kounst/daGloane/README.md

daGloane
========

daGloane is a quadcopter with a takeoff mass of less than 30grams
