kounst/daGloane/HW/eagle/Bluetooth_interface/BT_interface_layout.png

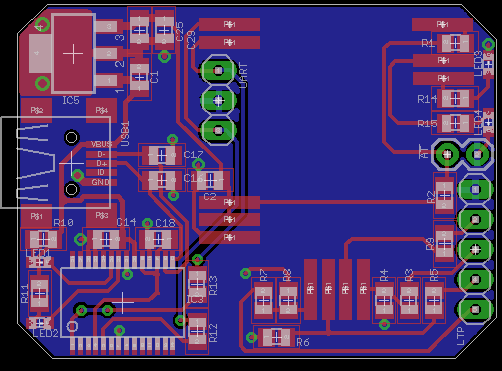
HW/eagle/Bluetooth_interface/BT_interface_layout.png
