kounst/daGloane/HW/eagle/Bluetooth_interface/BT_interface_schematic.png

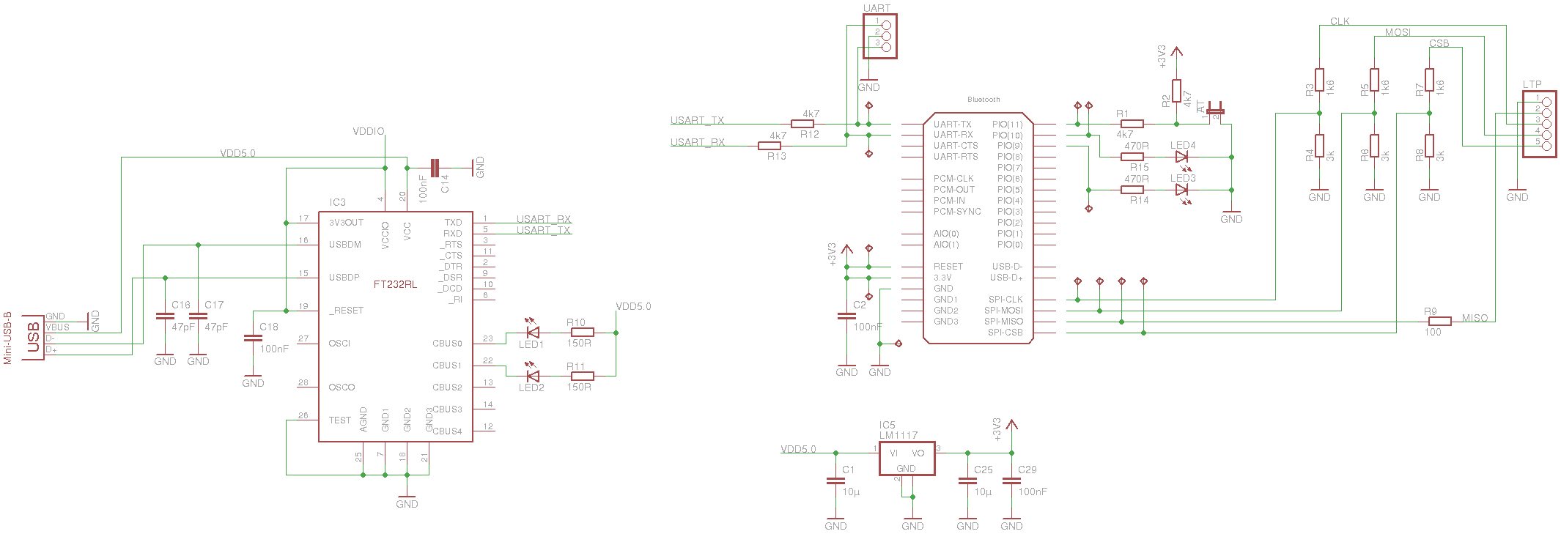
HW/eagle/Bluetooth_interface/BT_interface_schematic.png
