kounst/daGloane/HW/eagle/daGloane_schematic.png

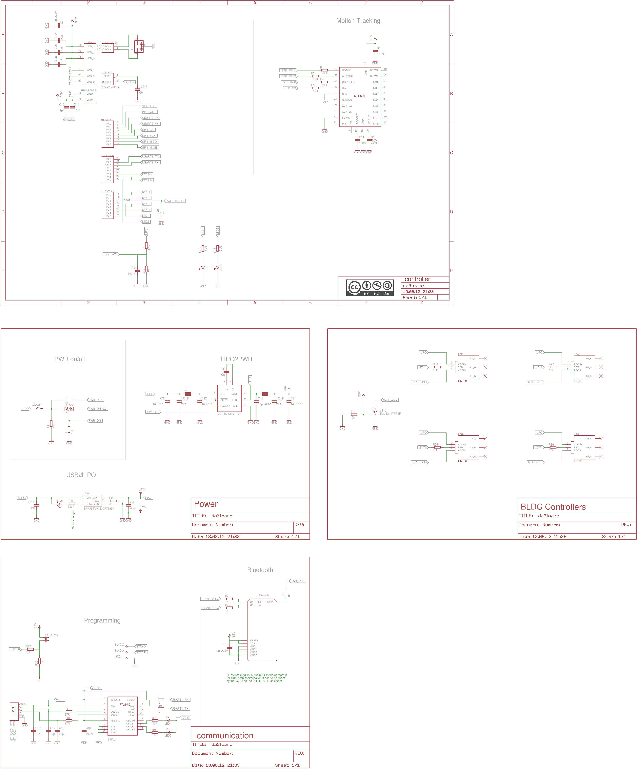
HW/eagle/daGloane_schematic.png
