kounst/daGloane/SW/src/simulink_control/daGloane_orientation.png

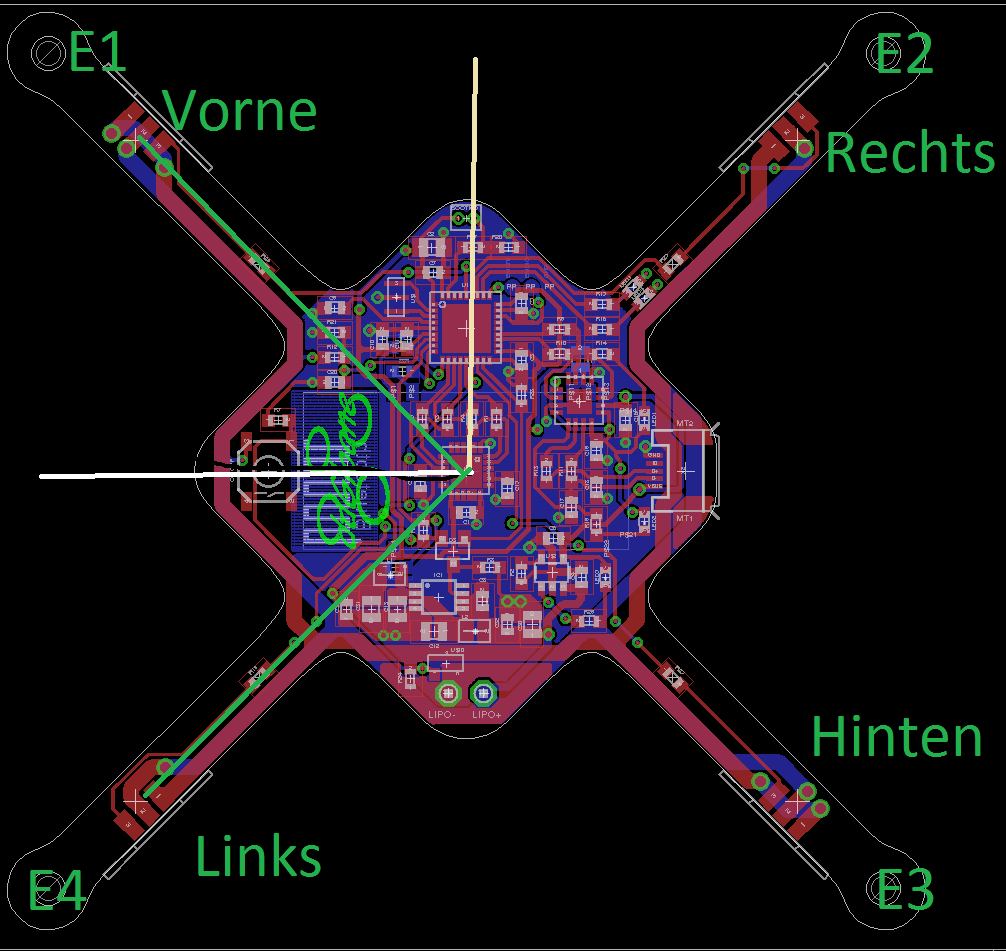
SW/src/simulink_control/daGloane_orientation.png
