kounst/daGloane/HW/Gewicht_abschätzung.ods

Abschätzung Gewicht daGloane
Bauteil | Anzahl | Stückgewicht/g | Gewicht/g | Kommentar
PCB mit 1929mm², 75%Kupferauslastung, 1.5mm Dicke | 1 | 7,57 | 7,57 | http://www.leiton.de/leiton-tools-gewichtsberechnung.html
Propeller | 4 | 0,6 | 2,4
Motor | 4 | 2 | 8
BLDC Regler | 4 | 0,4 | 1,6
Akku mit Kabel | 1 | 3,2 | 3,2
Bluetooth Modul | 1 | 2 | 2 | Schätzung
R 0603 | 30 | 0,002 | 0,06
C 0603 | 20 | 0,002 | 0,04
C 0805 | 3 | 0,008 | 0,024 | Schätzung: aus 0603 hochgerechnet
STM32 QFN32 | 1 | 0,13 | 0,13
FT230X QFN16 | 1 | 0,036 | 0,036
SOT23-3 Diode; Mosfet | 2 | 0,008 | 0,016
SOT23-5 LiPo lade IC | 1 | 0,012 | 0,012
MSOP-8 DC/DC | 1 | 0,025 | 0,025
MPU6000: QFN24 4x4 | 1 | 0,042 | 0,042 | Schätzung: wie R0603
LED | 5 | 0,002 | 0,01
Ceramic Resonator | 1 | 0,012 | 0,012
Lötzinn | 1 | 0,279 | 0,279 | Schätung: Lötzinn wiegt so viel wie Bauelemente
Micro USB B connector | 1 | 0,4 | 0,4 | Schätzung
Tactile Switch | 1 | 0,1 | 0,1
Jumper | 1 | 0,03 | 0,03 | Schätzung
Summe |  |  | 25,986
