kounst/daGloane/HW/CAD/PCB_serialWire.FCStd

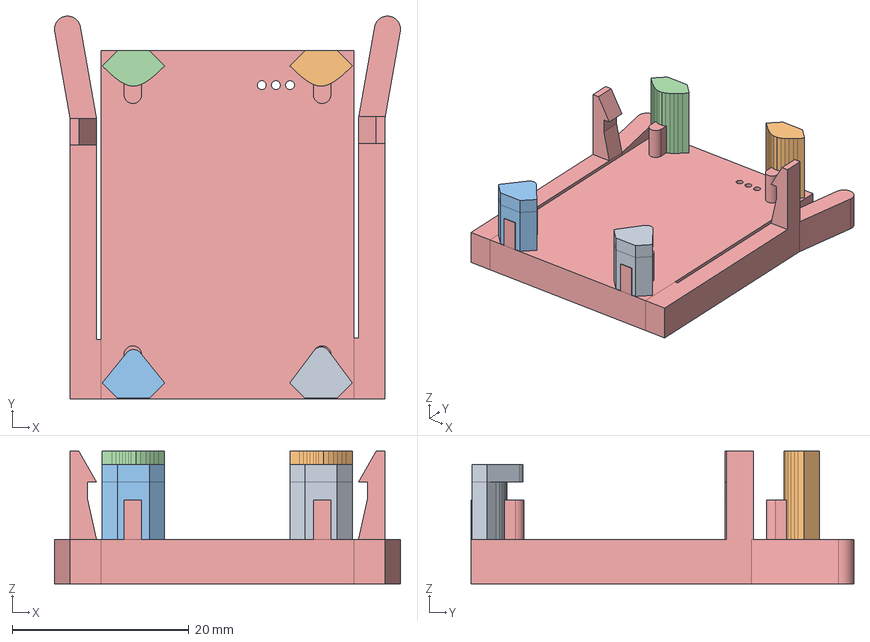
[picture p6: CAD file, 2021-02-18]
HW/CAD/PCB_serialWire.FCStd
39.1 x 43.3 x 15.0 mm
pillar_LR
pillar_UR
pillar_LL
pillar_UL
base
