kounst/daGloane/HW/CAD/SerialWire Fixture.stl

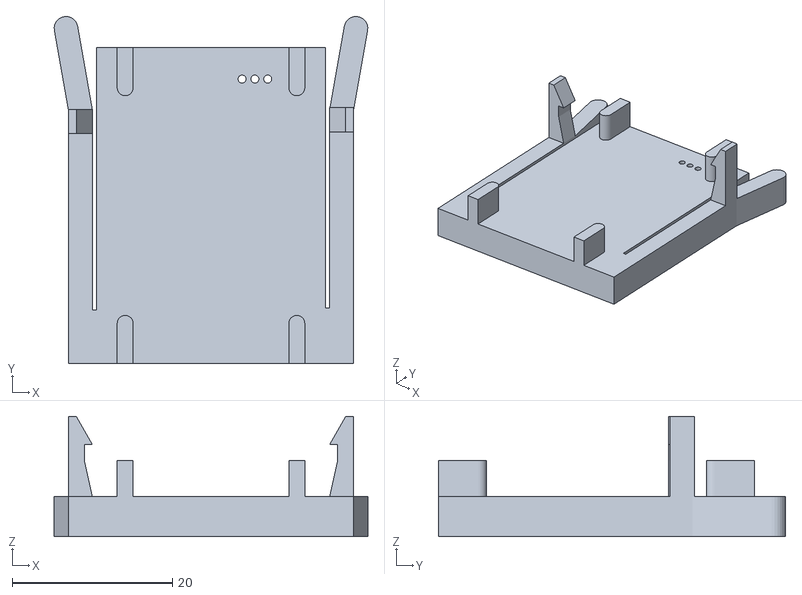
[picture p7: CAD file, 2021-02-18]
HW/CAD/SerialWire Fixture.stl
39.1 x 43.3 x 15.0
