kounst/daGloane/HW/CAD/DAGLOANE.STEP

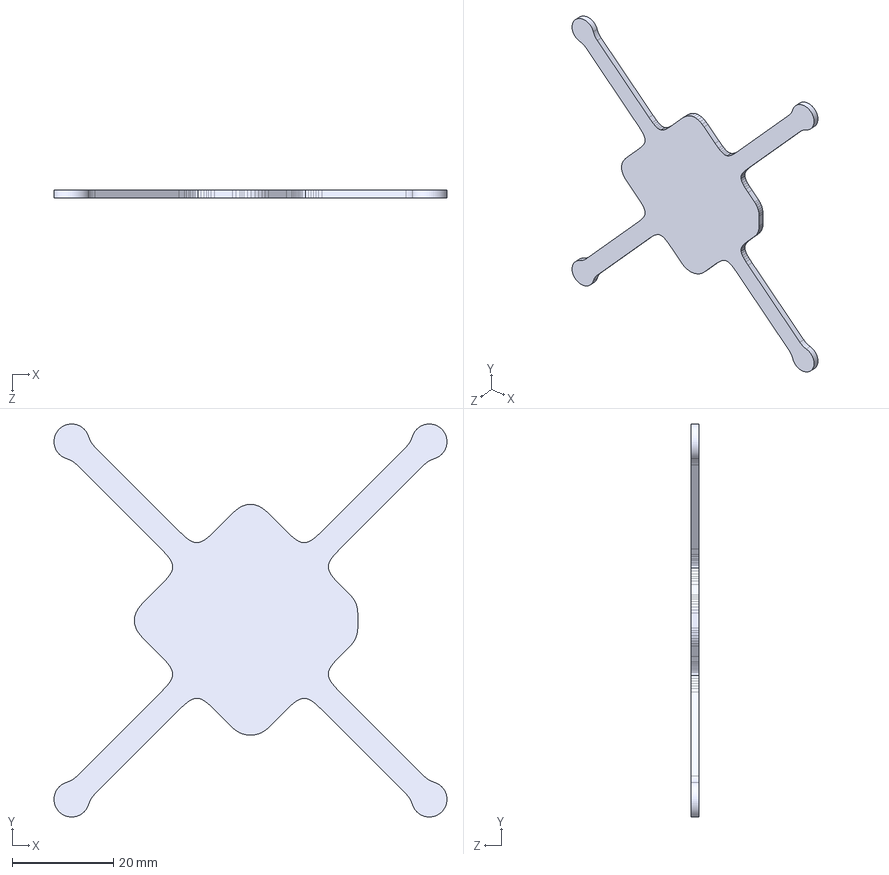
[picture p8: CAD file, 2021-02-15]
HW/CAD/DAGLOANE.STEP
77.7 x 77.7 x 1.60 mm
