kounst/daGloane/(list of files, cad)

Other CAD files:
HW/CAD/DAGLOANE.SLDPRT
