kounst/daGloane/HW/eagle/daGloane1.1.brd

## EAGLE design HW/eagle/daGloane1.1.brd (2013-03-10)

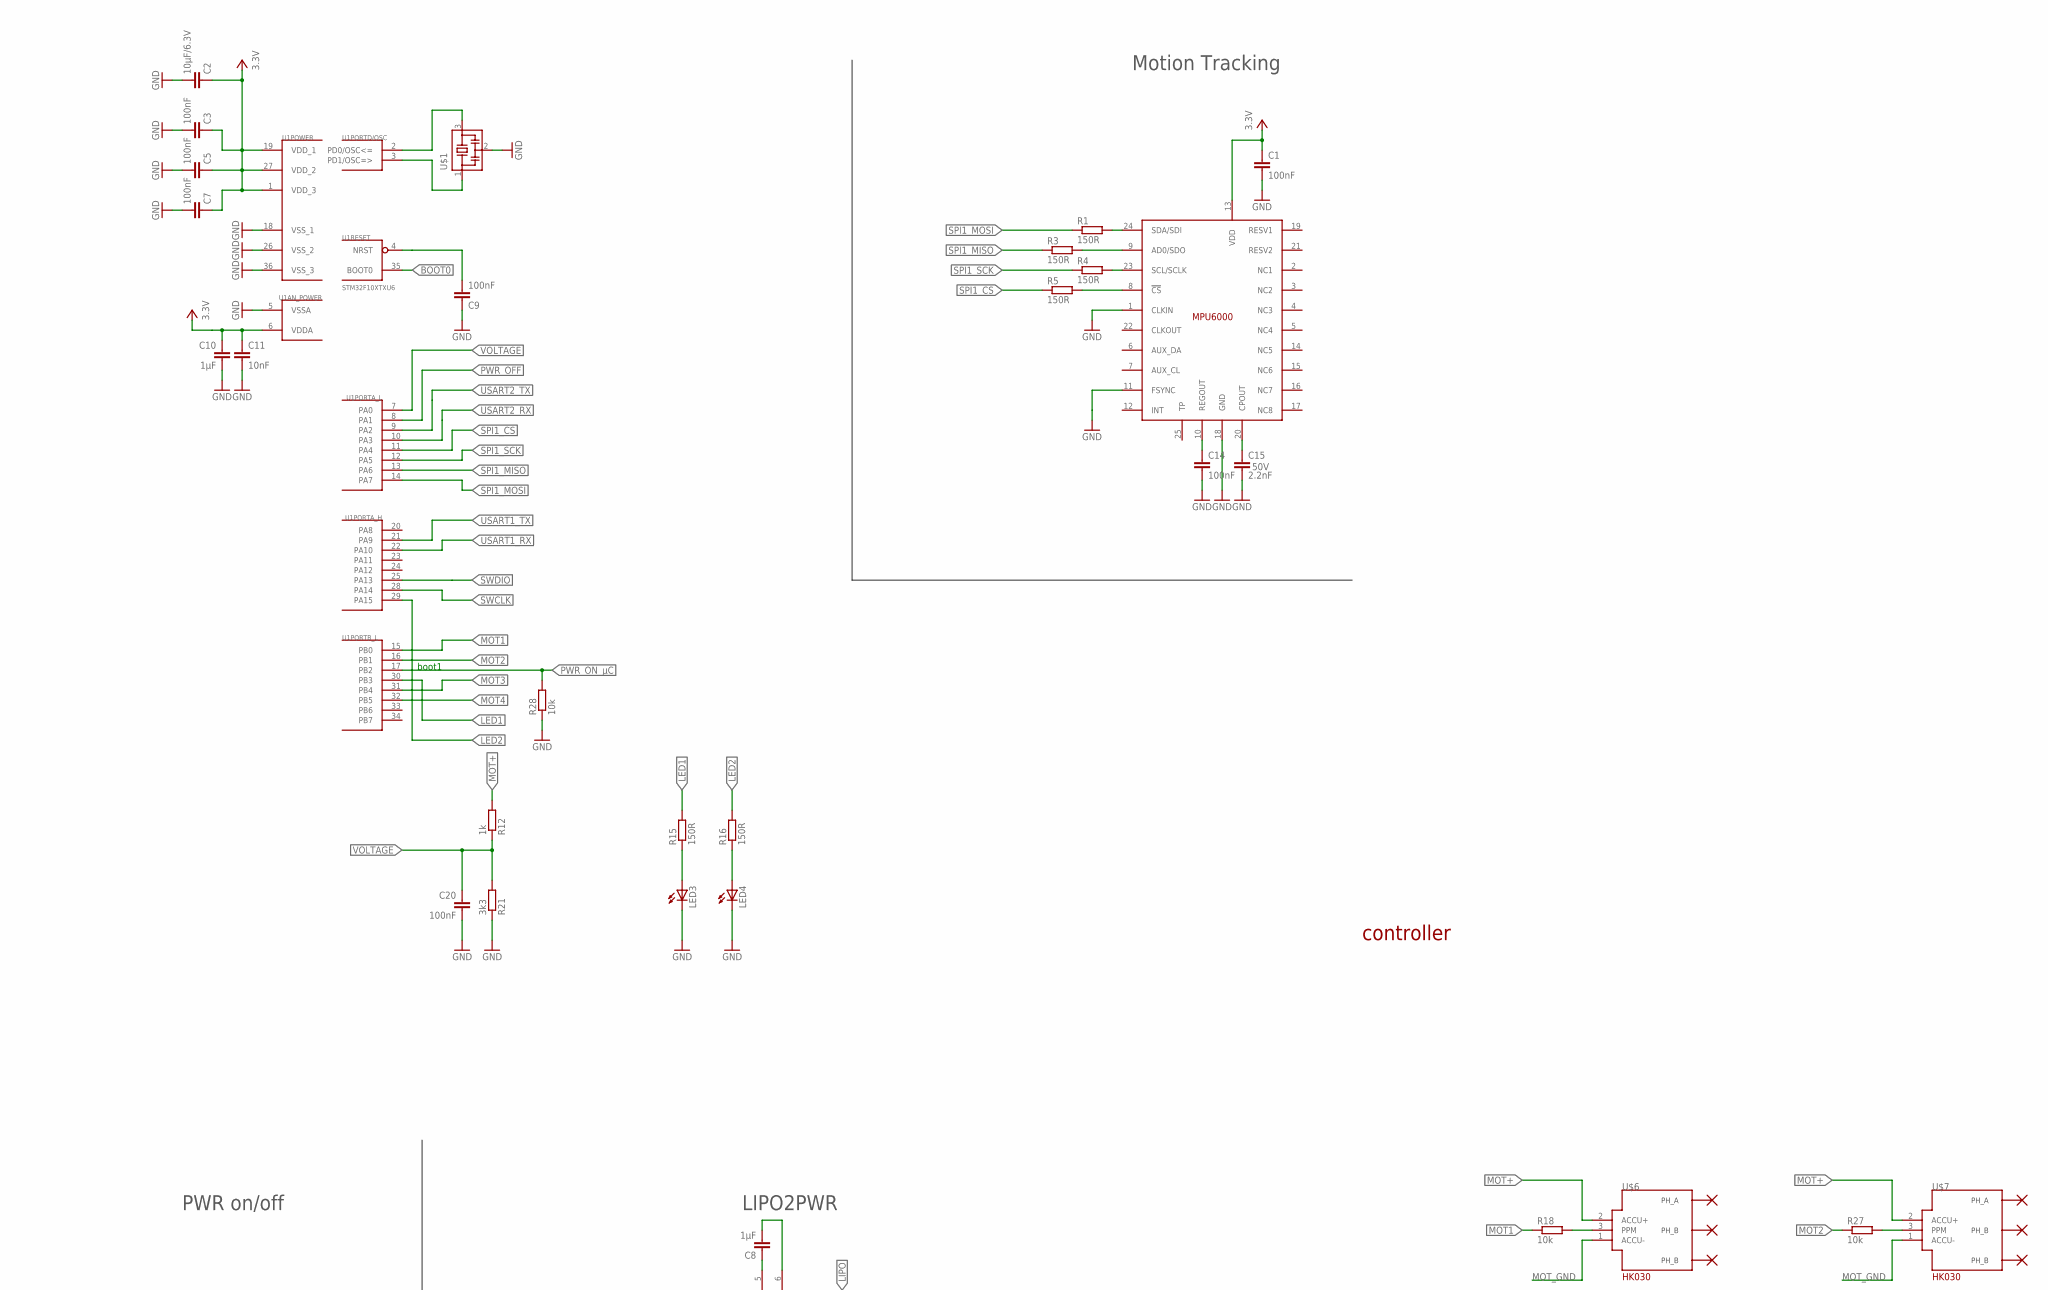
[picture p9: schematic daGloane1.1.sch, part in row 1, column 1]

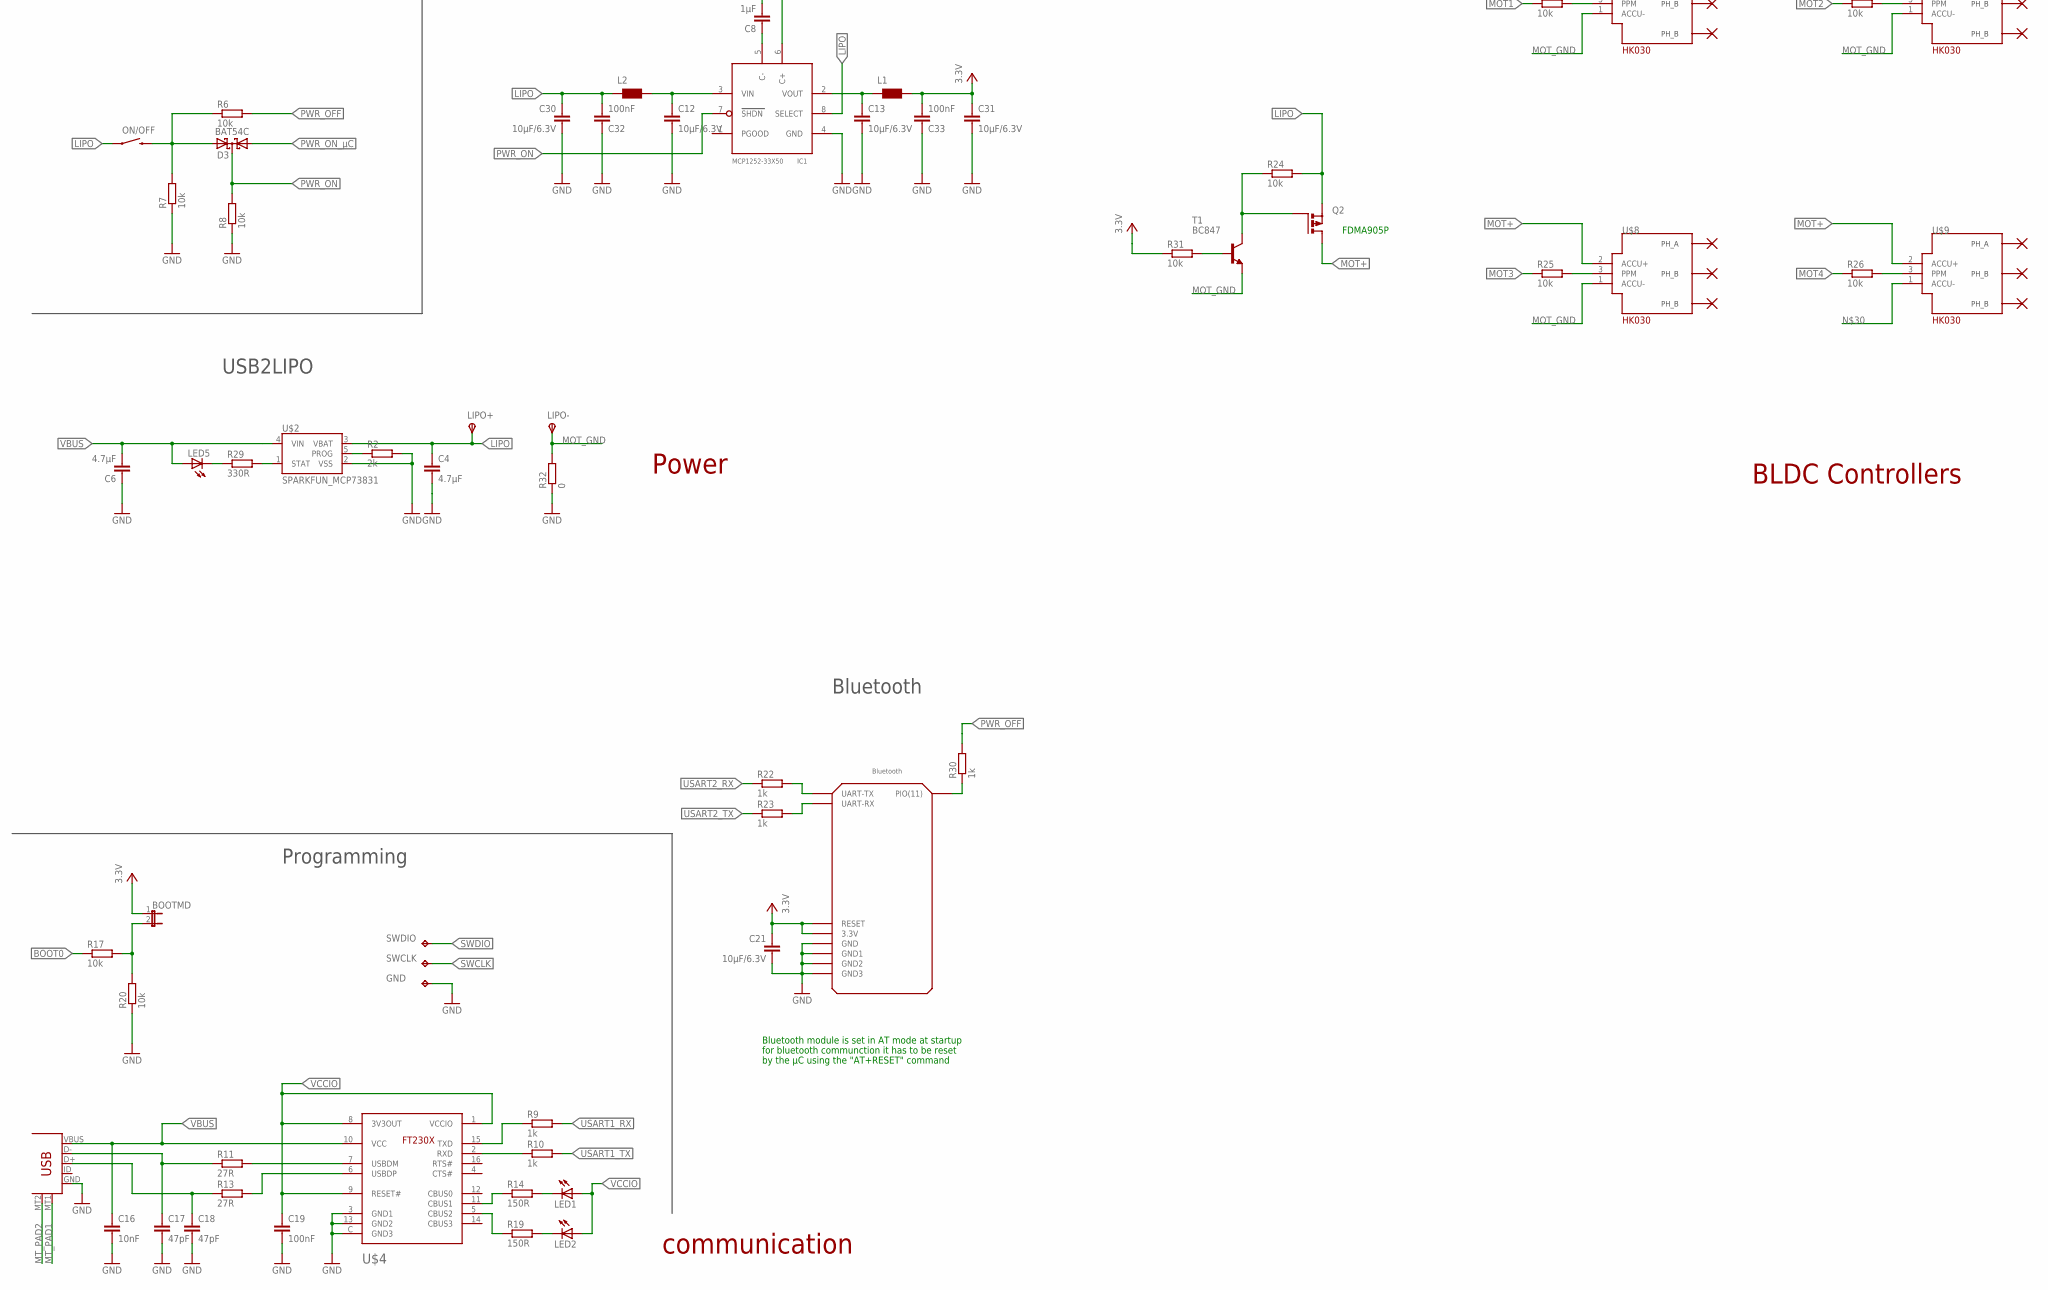
[picture p10: schematic daGloane1.1.sch, part in row 2, column 1]

Parts:
BOOTMD: JUMPER-2; 1X02_50MIL
C1, C3, C5, C7, C9, C14, C19, C20, C32, C33: 100nF; C0603
C2, C12, C13, C21, C30, C31: 10µF/6.3V; C0805
C4, C6: 4.7µF; C0603
C8, C10: 1µF; C0603
C11, C16: 10nF; C0603
C15: 2.2nF; C0603; VOLTAGE 50V
C17, C18: 47pF; C0603
D3: BAT54C; SOT23
GND: TESTPAD_TPB1,27; TESTPAD_B1,27
IC1: MCP1252-33X50; MSOP8
L1, L2: WUERTH-ELEKTRONIK_WE-KI_0805_B
LED1, LED2, LED3, LED4, LED5: LEDCHIPLED_0603; CHIPLED_0603
LIPO+: TPSPAD1-13; P1-13
LIPO-: TPSPAD1-13; P1-13
ON/OFF: SWITCH-MOMENTARY-2SMD; TACTILE_SWITCH_SMD
Q2: P-MOSFET-SO8; MICROFET2X2
R1, R3, R4, R5, R14, R15, R16, R19: 150R; R0603
R2: 2k; R0603
R6, R7, R8, R17, R18, R20, R24, R25, R26, R27, R28, R31: 10k; R0603
R9, R10, R12, R22, R23, R30: 1k; R0603
R11, R13: 27R; R0603
R21: 3k3; R0603
R29: 330R; R0603
R32: 0; R0603
SWCLK: TESTPAD_TPB1,27; TESTPAD_B1,27
SWDIO: TESTPAD_TPB1,27; TESTPAD_B1,27
T1: BC847; SOT23
U1: STM32F10XTXU6; VFQFPN36
U$1: MURATA-FILTER_CSTCE__G
U$2: SPARKFUN_MCP73831; SPARKFUN_SOT23-5
U$3: MPU6000
U$4: SERIAL_FT230XQ; SERIAL_QFN4X4-16
U$5: BLUETOOTH_REDUCED
U$6, U$7, U$8, U$9: 3A_BLDC_CONTROLLER
X2: USB_MICROB_PLUG_MT; SPARKFUN-CONNECTORS_USB-MICROB

Connections:
BOOT0: R17.1, U1.35 (BOOT0)
D+: C18.1, R13.1, X2.D+
D-: C17.1, R11.1, X2.D-
GND: C1.2, C2.2, C3.2, C4.2, C5.2, C6.1, C7.2, C9.1, C10.2, C11.2, C12.2, C13.2, C14.2, C15.2, C16.2, C17.2, C18.2, C19.2, C20.2, C21.2, C30.2, C31.2, C32.1, C33.1, GND.PP, IC1.4 (GND), LED3.C, LED4.C, R2.2, R7.1, R8.1, R20.1, R21.1, R28.1, R32.1, U1.5 (VSSA), U1.18 (VSS_1), U1.26 (VSS_2), U1.36 (VSS_3), U$1.2, U$2.2 (VSS), U$3.1 (CLKIN), U$3.11 (FSYNC), U$3.18 (GND), U$4.3 (GND1), U$4.13 (GND2), U$4.C (GND3), U$5.P$13 (GND), U$5.P$14 (GND1), U$5.P$21 (GND2), U$5.P$22 (GND3), X2.GND
LED1: R15.2, U1.30 (PB3)
LED2: R16.2, U1.29 (PA15)
LIPO: C4.1, C30.1, C32.2, IC1.8 (SELECT), L2.2 (1), LIPO+.TP, ON/OFF.1, Q2.P$4 (S), Q2.P$7 (S), R24.2, U$2.3 (VBAT)
MOT1: R18.1, U1.15 (PB0)
MOT2: R27.1, U1.16 (PB1)
MOT3: R25.1, U1.31 (PB4)
MOT4: R26.1, U1.32 (PB5)
MOT+: Q2.P$1 (D), Q2.P$2 (D), Q2.P$5 (D), Q2.P$6 (D), Q2.P$8 (D), R12.2, U$6.2 (ACCU+), U$7.2 (ACCU+), U$8.2 (ACCU+), U$9.2 (ACCU+)
MOT_GND: LIPO-.TP, R32.2, T1.2 (E), U$6.1 (ACCU-), U$7.1 (ACCU-), U$8.1 (ACCU-)
MT_PAD1: X2.MT1 (MTN1)
MT_PAD2: X2.MT2 (MTN2)
unnamed: LED2.C, R19.2
unnamed: U1.2 (PD0/OSC<=), U$1.3
unnamed: R2.1, U$2.5 (PROG)
unnamed: R5.2, U$3.8 (!CS)
unnamed: C15.1, U$3.20 (CPOUT)
unnamed: C14.1, U$3.10 (REGOUT)
unnamed: R22.2, U$5.P$1 (UART-TX)
unnamed: LED3.A, R15.1
unnamed: LED4.A, R16.1
unnamed: BOOTMD.2, R17.2, R20.2
unnamed: R14.1, U$4.11 (CBUS1)
unnamed: R19.1, U$4.5 (CBUS2)
unnamed: R4.2, U$3.23 (SCL/SCLK)
unnamed: LED1.C, R14.2
unnamed: R23.2, U$5.P$2 (UART-RX)
unnamed: R11.2, U$4.7 (USBDM)
unnamed: R13.2, U$4.6 (USBDP)
unnamed: R3.2, U$3.9 (AD0/SDO)
unnamed: R1.2, U$3.24 (SDA/SDI)
unnamed: R9.1, U$4.15 (TXD)
unnamed: R10.1, U$4.2 (RXD)
unnamed: R18.2, U$6.3 (PPM)
unnamed: D3.2 (A2), ON/OFF.3 (2), R6.1, R7.2
unnamed: C8.2, IC1.6 (C+)
unnamed: U1.3 (PD1/OSC=>), U$1.1
unnamed: R30.1, U$5.P$34 (PIO(11))
unnamed: Q2.P$3 (G), R24.1, T1.3 (C)
unnamed: C8.1, IC1.5 (C-)
unnamed: R31.2, T1.1 (B)
unnamed: R27.2, U$7.3 (PPM)
unnamed: R25.2, U$8.3 (PPM)
unnamed: R26.2, U$9.3 (PPM)
unnamed: R29.2, U$2.1 (STAT)
unnamed: LED5.C, R29.1
unnamed: C12.1, IC1.3 (VIN), L2.1 (2)
unnamed: C13.1, IC1.2 (VOUT), L1.2 (1)
PWR_OFF: R6.2, R30.2, U1.8 (PA1)
PWR_ON: D3.3 (CC), IC1.7 (SHDN), R8.2
PWR_ON_µC: D3.1 (A1), R28.2, U1.17 (PB2)
RESET1: C9.2, U1.4 (NRST)
SPI1_CS: R5.1, U1.11 (PA4)
SPI1_MISO: R3.1, U1.13 (PA6)
SPI1_MOSI: R1.1, U1.14 (PA7)
SPI1_SCK: R4.1, U1.12 (PA5)
SWCLK: SWCLK.PP, U1.28 (PA14)
SWDIO: SWDIO.PP, U1.25 (PA13)
USART1_RX: R9.2, U1.22 (PA10)
USART1_TX: R10.2, U1.21 (PA9)
USART2_RX: R22.1, U1.10 (PA3)
USART2_TX: R23.1, U1.9 (PA2)
VBUS: C6.2, C16.1, LED5.A, U$2.4 (VIN), U$4.10 (VCC), X2.VBUS
VCC: BOOTMD.1, C1.1, C2.1, C3.1, C5.1, C7.1, C10.1, C11.1, C21.1, C31.1, C33.2, L1.1 (2), R31.1, U1.1 (VDD_3), U1.6 (VDDA), U1.19 (VDD_1), U1.27 (VDD_2), U$3.13 (VDD), U$5.P$11 (RESET), U$5.P$12 (3.3V)
VCCIO: C19.1, LED1.A, LED2.A, U$4.1 (VCCIO), U$4.8 (3V3OUT), U$4.9 (RESET#)
VOLTAGE: C20.1, R12.1, R21.2, U1.7 (PA0)

Notes on the sheet:
FT230X
boot1
Power
communication
controller
Programming
Bluetooth
LIPO2PWR
USB2LIPO
PWR on/off
Motion Tracking
BLDC Controllers
Bluetooth module is set in AT mode at startup
for bluetooth communction it has to be reset
by the µC using the "AT+RESET" command
FDMA905P

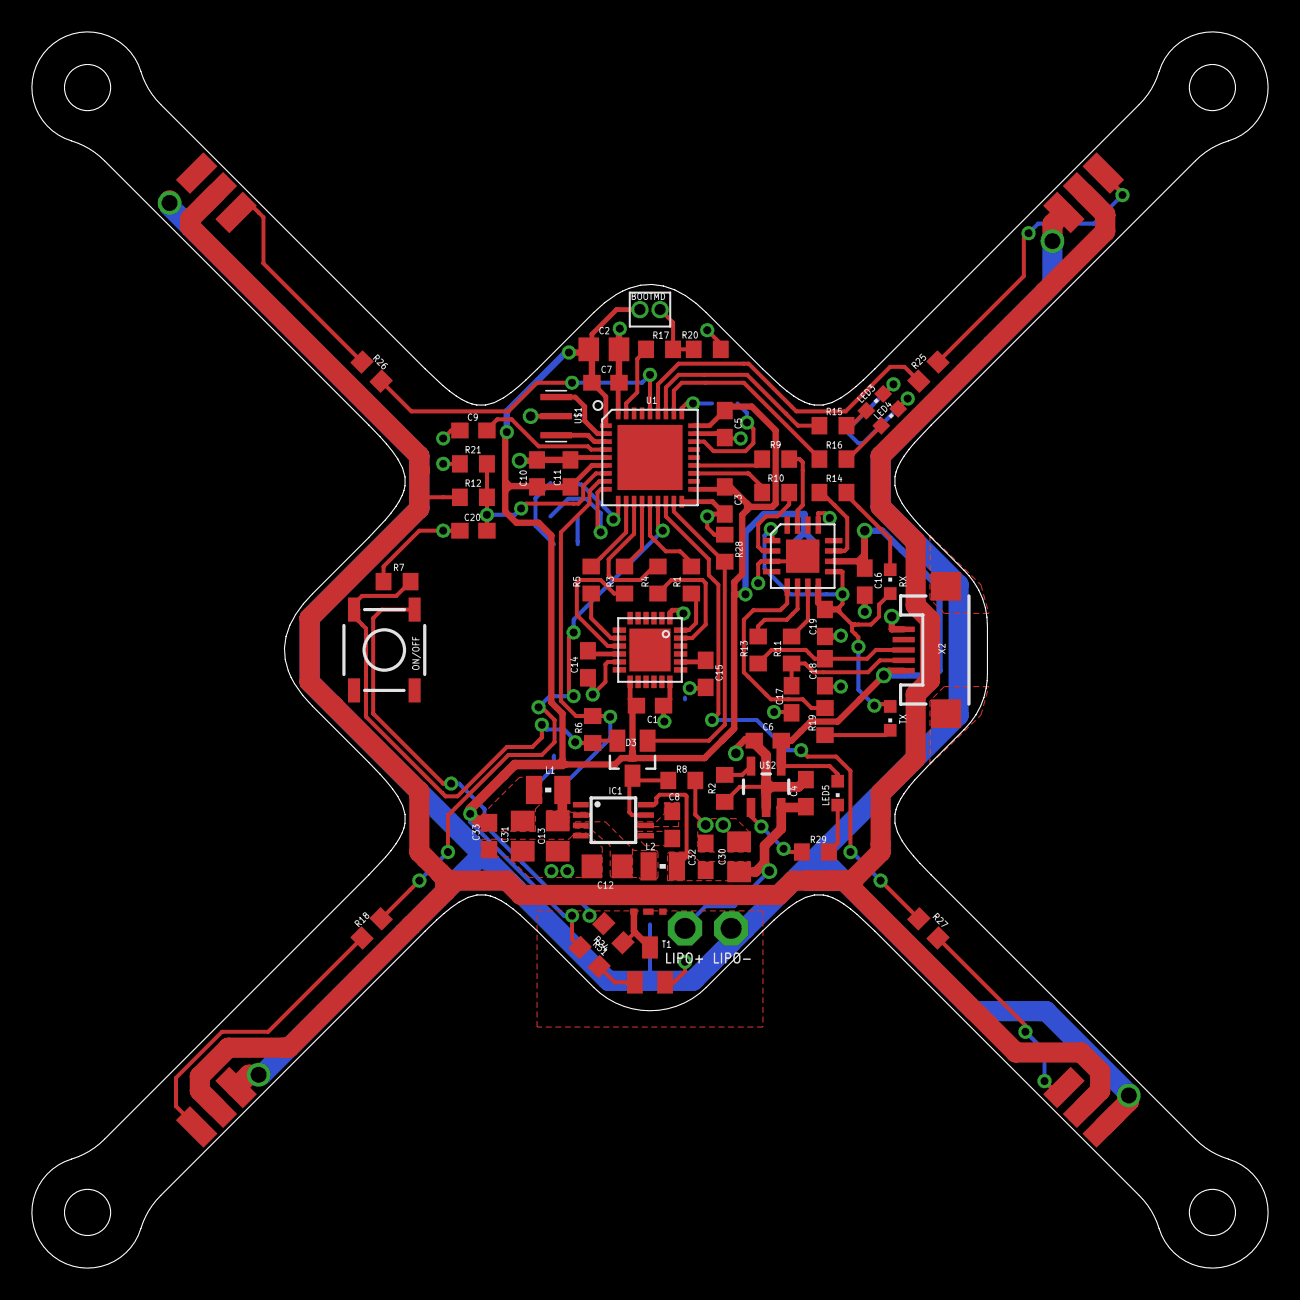
[picture p11: board daGloane1.1.brd from above]

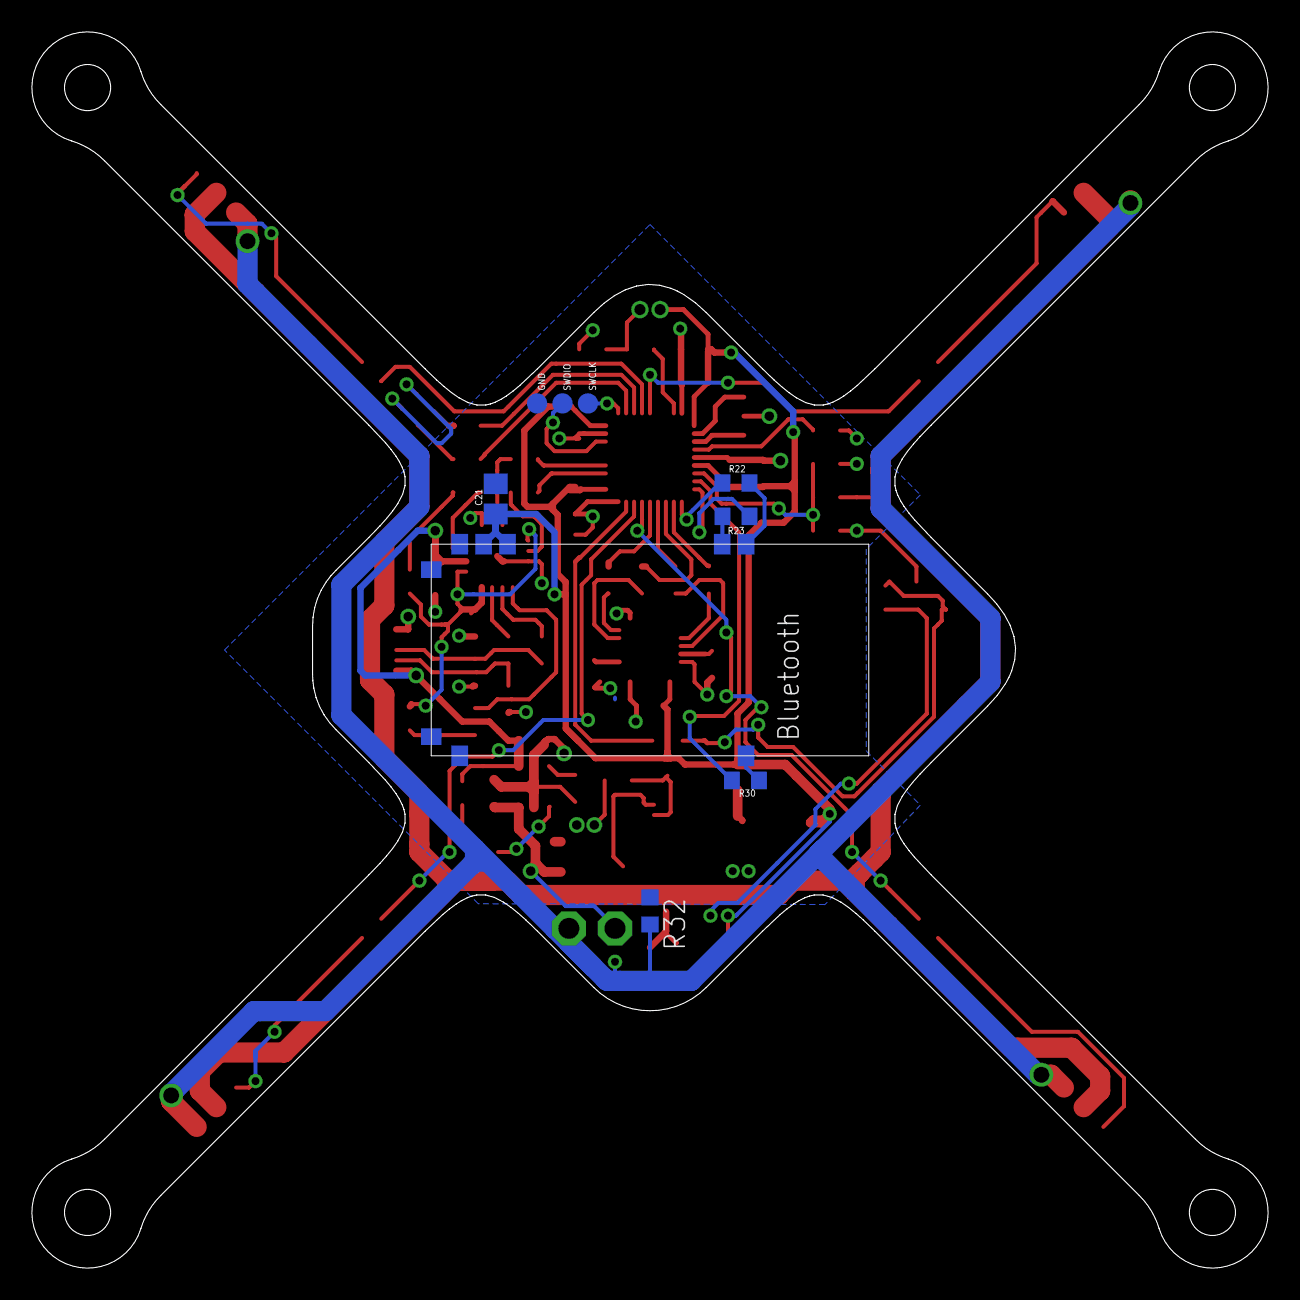
[picture p12: board daGloane1.1.brd from below]

Board: 2 copper layers, 77.7 x 77.7 mm, 87 parts (9 on the bottom side), 67 nets.

Other parts of the board:
U$11: DAGLOANE_LOGO
