kounst/daGloane/HW/eagle/Bluetooth_interface/BT_interface.brd

## EAGLE design HW/eagle/Bluetooth_interface/BT_interface.brd (2012-08-12)

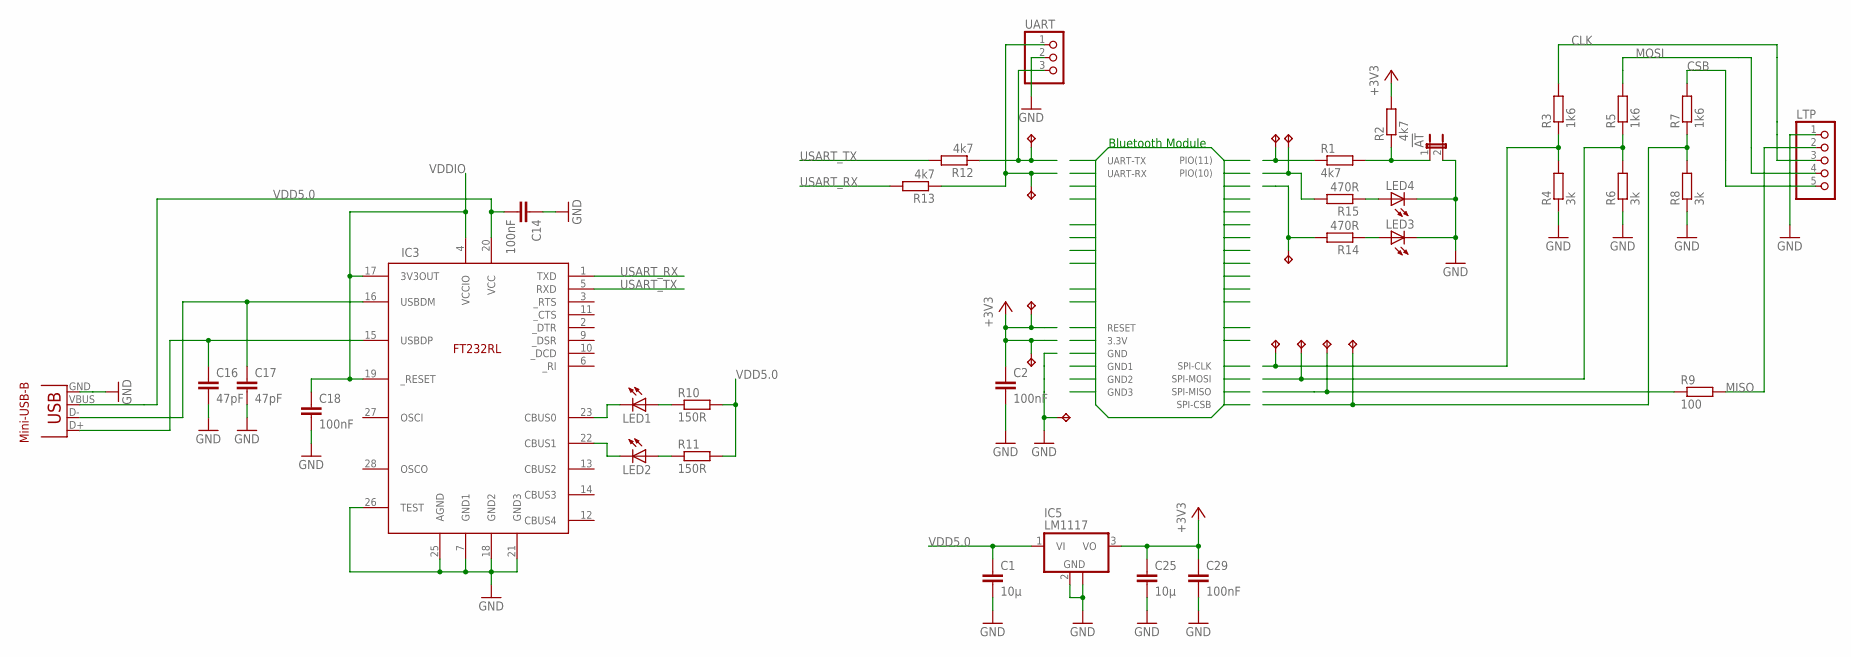
[picture p13: schematic BT_interface.sch]

Parts:
!AT: JUMPER-2PTH; 1X02
C1, C25: 10µ; C0805
C2, C14, C18, C29: 100nF; C0805
C16, C17: 47pF; C0805
IC3: FT232RL; SSOP28DB
IC5: UA78M05DCY; SOT223
LED1, LED2, LED3, LED4: LEDCHIPLED_0603; CHIPLED_0603
LTP: PINHD-1X5; 1X05
R1, R2, R12, R13: 4k7; R0805
R3, R5, R7: 1k6; R0805
R4, R6, R8: 3k; R0805
R9: 100; R0805
R10, R11: 150R; R0805
R14, R15: 470R; R0805
U$2, U$3, U$4, U$5, U$6, U$7, U$8, U$9, U$10, U$11, U$12, U$13: SPRING_HEADER
UART: PINHD-1X3; 1X03
USB1: USB-MB-S2; USB-MP-S2

Connections:
+3V3: C2.1, C25.1, C29.1, IC5.3 (VO), R2.2, U$4.P$1, U$5.P$1
CLK: LTP.3, R3.2
CSB: LTP.5, R7.2
D+: C16.1, IC3.15 (USBDP), USB1.D+
D-: C17.1, IC3.16 (USBDM), USB1.D-
GND: !AT.2, C1.2, C2.2, C14.1, C16.2, C17.2, C18.2, C25.2, C29.2, IC3.7 (GND1), IC3.18 (GND2), IC3.21 (GND3), IC3.25 (AGND), IC3.26 (TEST), IC5.2 (GND), IC5.4 (GND), LED3.C, LED4.C, LTP.1, R4.1, R6.1, R8.1, U$6.P$1, UART.2, USB1.GND
MISO: LTP.2, R9.2
MOSI: LTP.4, R5.2
unnamed: R1.1, U$9.P$1
unnamed: IC3.23 (CBUS0), LED1.C
unnamed: IC3.22 (CBUS1), LED2.C
unnamed: LED1.A, R10.1
unnamed: LED2.A, R11.1
unnamed: !AT.1, R1.2, R2.1
unnamed: R7.1, R8.2, U$11.P$1
unnamed: R5.1, R6.2, U$7.P$1
unnamed: R3.1, R4.2, U$8.P$1
unnamed: R12.1, U$2.P$1, UART.3
unnamed: R13.1, U$3.P$1, UART.1
unnamed: LED3.A, R14.1
unnamed: LED4.A, R15.1
unnamed: R14.2, U$13.P$1
unnamed: R9.1, U$10.P$1
unnamed: R15.2, U$12.P$1
USART_RX: IC3.1 (TXD), R13.2
USART_TX: IC3.5 (RXD), R12.2
VDD5.0: C1.1, C14.2, IC3.20 (VCC), IC5.1 (VI), R10.2, R11.2, USB1.VBUS
VDDIO: C18.1, IC3.4 (VCCIO), IC3.17 (3V3OUT), IC3.19 (_RESET)

Notes on the sheet:
FT232RL
Mini-USB-B
UART-TX
UART-RX
RESET
3.3V
GND
GND1
GND2
GND3
SPI-CSB
SPI-MISO
SPI-MOSI
SPI-CLK
PIO(11)
PIO(10)
Bluetooth Module

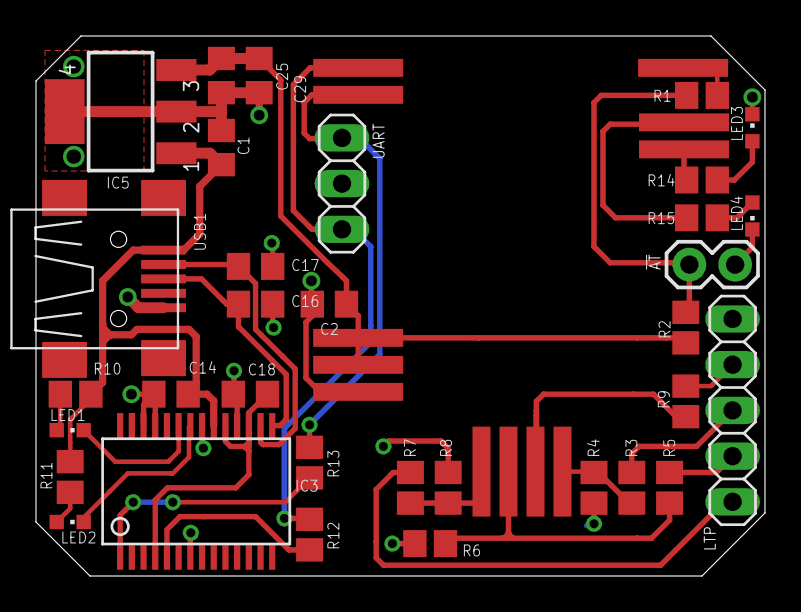
[picture p14: board BT_interface.brd from above]

Board: 2 copper layers, 40.5 x 30.0 mm, 45 parts (0 on the bottom side), 28 nets.
