kounst/daGloane/HW/eagle/daGloane_panel.brd

## EAGLE design HW/eagle/daGloane_panel.brd (2012-08-12)

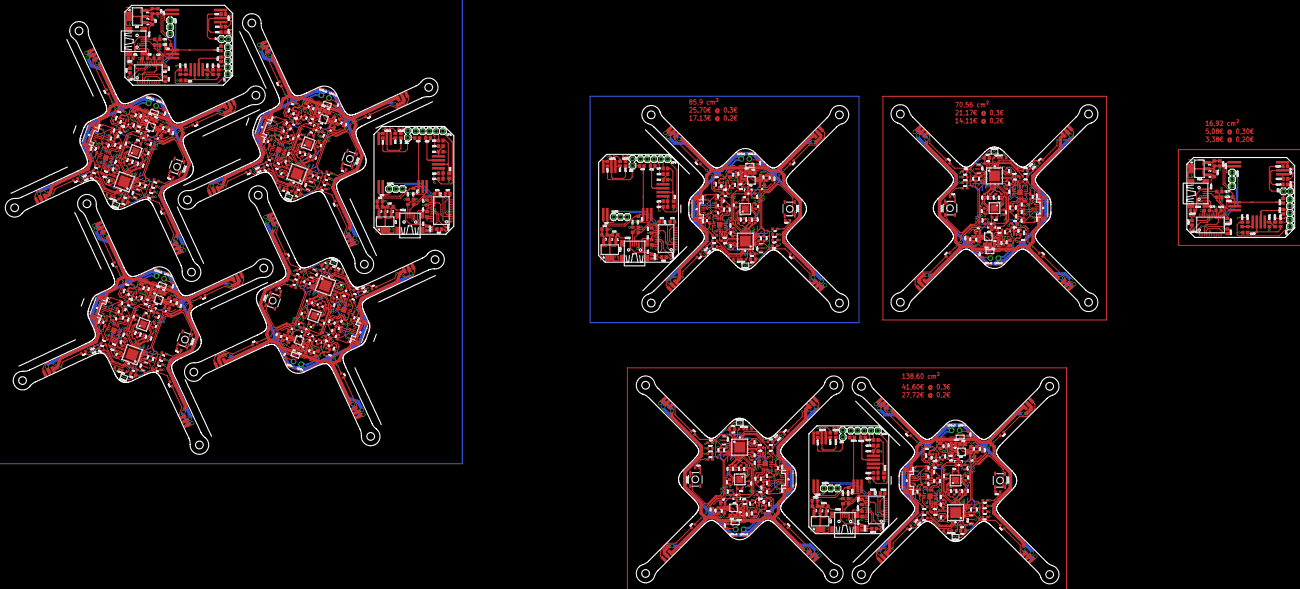
[picture p15: board daGloane_panel.brd from above]

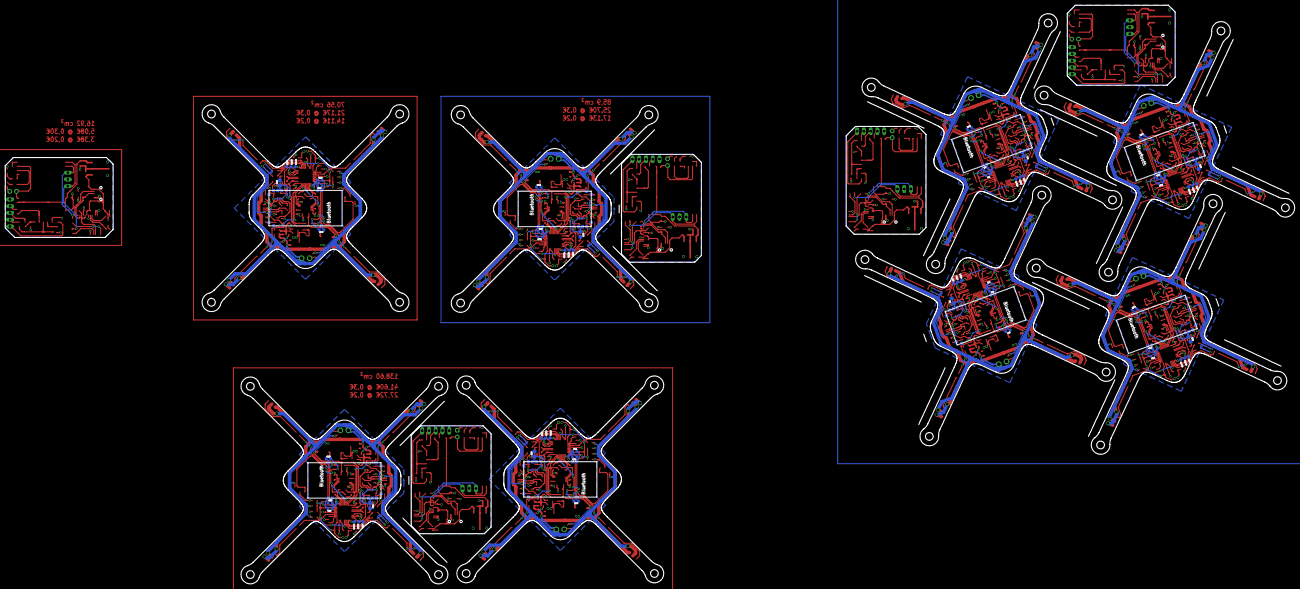
[picture p16: board daGloane_panel.brd from below]

Board: 2 copper layers, 484.4 x 217.4 mm, 897 parts (64 on the bottom side), 652 nets.

Parts:
!AT, !AT1, !AT2, !AT3, !AT4: 1X02
BOOTMD, BOOTMD1, BOOTMD2, BOOTMD3, BOOTMD4, BOOTMD5, BOOTMD6, BOOTMD7: 1X02_50MIL
C1, C3, C5, C7, C9, C14, C19, C20, C32, C33, C50, C53, C55, C57, C59, C62, C64, C66, C72, C73, C74, C75, C82, C83, C84, C87, C89, C91, C97, C98, C99, C100, C107, C108, C109, C112, C114, C116, C122, C123, C124, C125, C132, C133, C138, C139, C140, C141, C148, C149, C150, C153, C155, C157, C163, C164, C165, C166, C173, C174, C183, C186, C188, C190, C196, C197, C198, C199, C206, C207, C216, C219, C221, C223, C229, C230, C231, C232, C239, C240: 100nF; C0603
C2, C12, C13, C21, C30, C31, C69, C70, C76, C79, C80, C81, C94, C95, C101, C104, C105, C106, C119, C120, C126, C129, C130, C131, C135, C136, C142, C145, C146, C147, C160, C161, C167, C170, C171, C172, C193, C194, C200, C203, C204, C205, C226, C227, C233, C236, C237, C238: 10µF/6.3V; C0805
C4, C68, C93, C118, C134, C159, C192, C225: 4.7; C0603
C6, C58, C67, C92, C117, C158, C191, C224: 4.7µF; C0603
C8, C10, C71, C78, C96, C103, C121, C128, C137, C144, C162, C169, C195, C202, C228, C235: 1µF; C0603
C11, C16, C54, C63, C77, C88, C102, C113, C127, C143, C154, C168, C187, C201, C220, C234: 10nF; C0603
C15, C56, C65, C90, C115, C156, C189, C222: 2.2nF; C0603
C17, C18, C51, C52, C60, C61, C85, C86, C110, C111, C151, C152, C184, C185, C217, C218: 47pF; C0603
C22, C25, C28, C29, C34, C37, C39, C41, C42, C45, C47, C49, C175, C178, C180, C182, C208, C211, C213, C215: 100nF; C0805
C23, C24, C35, C36, C43, C44, C176, C177, C209, C210: 47pF; C0805
C26, C27, C38, C40, C46, C48, C179, C181, C212, C214: 10µ; C0805
D1, D2, D3, D4, D5, D6, D7, D8: BAT54C; SOT23
GND, GND1, GND2, GND3, GND4, GND5, GND6, GND7: TESTPAD_TPB1,27; TESTPAD_B1,27
IC1, IC4, IC6, IC7, IC11, IC12, IC15, IC18: MCP1252-33X50; MSOP8
IC2, IC3, IC9, IC13, IC16: FT232RL; SSOP28DB
IC5, IC8, IC10, IC14, IC17: UA78M05DCY; SOT223
L1, L2, L3, L4, L5, L6, L7, L8, L9, L10, L11, L12, L13, L14, L15, L16: WUERTH-ELEKTRONIK_WE-KI_0805_B
LED1, LED2, LED3, LED4, LED5, LED6, LED7, LED8, LED9, LED10, LED11, LED12, LED13, LED14, LED15, LED16, LED17, LED18, LED19, LED20, LED21, LED22, LED23, LED24, LED25, LED26, LED27, LED28, LED29, LED30, LED31, LED32, LED33, LED34, LED35, LED36, LED37, LED38, LED39, LED40, LED41, LED42, LED43, LED44, LED45, LED46, LED47, LED48, LED49, LED50, LED51, LED52, LED53, LED54, LED55, LED56, LED57, LED58, LED59, LED60: CHIPLED_0603
LIPO+, LIPO+1, LIPO+2, LIPO+3, LIPO+4, LIPO+5, LIPO+6, LIPO+7: TPSPAD1-13; P1-13
LIPO-, LIPO-1, LIPO-2, LIPO-3, LIPO-4, LIPO-5, LIPO-6, LIPO-7: TPSPAD1-13; P1-13
LTP, LTP1, LTP2, LTP3, LTP4: 1X05
ON/OFF, ON/OFF1, ON/OFF2, ON/OFF3, ON/OFF4, ON/OFF5, ON/OFF6, ON/OFF7: SWITCH-MOMENTARY-2SMD; TACTILE_SWITCH_SMD
R1, R3, R4, R5, R14, R15, R16, R19, R76, R81, R82, R83, R86, R87, R88, R89, R106, R111, R112, R113, R116, R117, R118, R119, R136, R141, R142, R143, R146, R147, R148, R149, R166, R171, R172, R173, R176, R177, R178, R179, R196, R201, R202, R203, R206, R207, R208, R209, R241, R246, R247, R248, R251, R252, R253, R254, R286, R291, R292, R293, R296, R297, R298, R299: 150R; R0603
R2, R92, R122, R152, R182, R212, R257, R302: 2k; R0603
R6, R7, R8, R17, R18, R20, R24, R25, R26, R27, R28, R77, R78, R93, R94, R95, R98, R100, R101, R102, R103, R104, R107, R108, R123, R124, R125, R128, R130, R131, R132, R133, R134, R137, R138, R153, R154, R155, R158, R160, R161, R162, R163, R164, R167, R168, R183, R184, R185, R188, R190, R191, R192, R193, R194, R197, R198, R213, R214, R215, R218, R220, R221, R222, R223, R224, R242, R243, R258, R259, R260, R263, R265, R266, R267, R268, R269, R287, R288, R303, R304, R305, R308, R310, R311, R312, R313, R314: 10k; R0603
R9, R10, R12, R22, R23, R30, R79, R90, R91, R96, R97, R105, R109, R120, R121, R126, R127, R135, R139, R150, R151, R156, R157, R165, R169, R180, R181, R186, R187, R195, R199, R210, R211, R216, R217, R225, R244, R255, R256, R261, R262, R270, R289, R300, R301, R306, R307, R315: 1k; R0603
R11, R13, R84, R85, R114, R115, R144, R145, R174, R175, R204, R205, R249, R250, R294, R295: 27R; R0603
R21, R80, R110, R140, R170, R200, R245, R290: 3k3; R0603
R29, R99, R129, R159, R189, R219, R264, R309: 330; R0603
R31, R32, R46, R47, R61, R62, R226, R227, R271, R272: 150R; R0805
R33, R34, R42, R43, R48, R49, R57, R58, R63, R64, R72, R73, R228, R229, R237, R238, R273, R274, R282, R283: 4k7; R0805
R35, R37, R39, R50, R52, R54, R65, R67, R69, R230, R232, R234, R275, R277, R279: 1k6; R0805
R36, R38, R40, R51, R53, R55, R66, R68, R70, R231, R233, R235, R276, R278, R280: 3k; R0805
R41, R56, R71, R236, R281: 100; R0805
R44, R45, R59, R60, R74, R75, R239, R240, R284, R285: 470R; R0805
SWCLK, SWCLK1, SWCLK2, SWCLK3, SWCLK4, SWCLK5, SWCLK6, SWCLK7: TESTPAD_TPB1,27; TESTPAD_B1,27
SWDIO, SWDIO1, SWDIO2, SWDIO3, SWDIO4, SWDIO5, SWDIO6, SWDIO7: TESTPAD_TPB1,27; TESTPAD_B1,27
U1, U2, U3, U4, U5, U6, U7, U8: STM32F10XTXU6; VFQFPN36
U$1, U$38, U$49, U$60, U$84, U$95, U$118, U$141: MURATA-FILTER_CSTCE__G
U$2, U$37, U$48, U$59, U$83, U$94, U$117, U$140: SPARKFUN_MCP73831; SPARKFUN_SOT23-5
U$3, U$35, U$46, U$57, U$81, U$92, U$115, U$138: MPU6000
U$4, U$36, U$47, U$58, U$82, U$93, U$116, U$139: SERIAL_FT230XQ; SERIAL_QFN4X4-16
U$5, U$40, U$51, U$62, U$86, U$97, U$120, U$143: BLUETOOTH_REDUCED
U$6, U$7, U$8, U$9, U$41, U$42, U$43, U$44, U$52, U$53, U$54, U$55, U$63, U$64, U$65, U$66, U$87, U$88, U$89, U$90, U$98, U$99, U$100, U$101, U$121, U$122, U$123, U$124, U$144, U$145, U$146, U$147: 3A_BLDC_CONTROLLER
U$10, U$39, U$50, U$61, U$85, U$96, U$119, U$142: IRLM6344TRPBF; MICRO3(SOT-23)
U$11, U$45, U$56, U$67, U$91, U$102, U$125, U$148: DAGLOANE_LOGO
U$12, U$13, U$14, U$15, U$16, U$17, U$18, U$19, U$20, U$21, U$22, U$23, U$24, U$25, U$26, U$27, U$28, U$29, U$30, U$31, U$32, U$33, U$34, U$68, U$69, U$70, U$71, U$72, U$73, U$74, U$75, U$76, U$77, U$78, U$79, U$80, U$103, U$104, U$105, U$106, U$107, U$108, U$109, U$110, U$111, U$112, U$113, U$114, U$126, U$127, U$128, U$129, U$130, U$131, U$132, U$133, U$134, U$135, U$136, U$137: SPRING_HEADER
UART, UART1, UART2, UART3, UART4: 1X03
USB1, USB2, USB3, USB4, USB5: USB-MB-S2; USB-MP-S2
X1, X2, X3, X4, X5, X6, X7, X8: USB_MICROB_PLUG_MT; SPARKFUN-CONNECTORS_USB-MICROB

Connections:
+3V1: C38.1, C39.1, C41.1, IC8.3, R49.2, U$26.P$1, U$30.P$1
+3V2: C46.1, C47.1, C49.1, IC10.3, R64.2, U$71.P$1, U$75.P$1
+3V3: C26.1, C28.1, C29.1, IC5.3, R34.2, U$14.P$1, U$18.P$1
+3V4: C179.1, C180.1, C182.1, IC14.3, R229.2, U$105.P$1, U$109.P$1
+3V5: C212.1, C213.1, C215.1, IC17.3, R274.2, U$128.P$1, U$132.P$1
BOOT0: R17.1, U1.35
BOOT1: R168.1, U2.35
BOOT2: R78.1, U3.35
BOOT3: R108.1, U4.35
BOOT4: R138.1, U5.35
BOOT5: R198.1, U6.35
BOOT6: R243.1, U7.35
BOOT7: R288.1, U8.35
CLK: LTP.3, R35.2
CLK1: LTP1.3, R50.2
CLK2: LTP2.3, R65.2
CLK3: LTP3.3, R230.2
CLK4: LTP4.3, R275.2
CSB: LTP.5, R39.2
CSB1: LTP1.5, R54.2
CSB2: LTP2.5, R69.2
CSB3: LTP3.5, R234.2
CSB4: LTP4.5, R279.2
D+: C18.1, R13.1, X2.D+
D+1: C23.1, IC3.15, USB1.D+
D+2: C35.1, IC2.15, USB2.D+
D+3: C60.1, R85.1, X3.D+
D+4: C85.1, R115.1, X4.D+
D+5: C110.1, R145.1, X5.D+
D+6: C43.1, IC9.15, USB3.D+
D+7: C51.1, R175.1, X1.D+
D+8: C151.1, R205.1, X6.D+
D+9: C176.1, IC13.15, USB4.D+
D+10: C184.1, R250.1, X7.D+
D+11: C209.1, IC16.15, USB5.D+
D+12: C217.1, R295.1, X8.D+
D-: C17.1, R11.1, X2.D-
D-1: C24.1, IC3.16, USB1.D-
D-2: C36.1, IC2.16, USB2.D-
D-3: C61.1, R84.1, X3.D-
D-4: C86.1, R114.1, X4.D-
D-5: C111.1, R144.1, X5.D-
D-6: C44.1, IC9.16, USB3.D-
D-7: C52.1, R174.1, X1.D-
D-8: C152.1, R204.1, X6.D-
D-9: C177.1, IC13.16, USB4.D-
D-10: C185.1, R249.1, X7.D-
D-11: C210.1, IC16.16, USB5.D-
D-12: C218.1, R294.1, X8.D-
GND: C1.2, C2.2, C3.2, C4.2, C5.2, C6.1, C7.2, C9.1, C10.2, C11.2, C12.2, C13.2, C14.2, C15.2, C16.2, C17.2, C18.2, C19.2, C20.2, C21.2, C30.2, C31.2, C32.1, C33.1, GND.PP, IC1.4, LED3.C, LED4.C, LIPO-.TP, R2.2, R7.1, R8.1, R20.1, R21.1, R24.1, R28.1, U1.5, U1.18, U1.26, U1.36, U$1.2, U$2.2, U$3.1, U$3.11, U$3.18, U$4.3, U$4.13, U$4.C, U$5.P$13, U$5.P$14, U$5.P$21, U$5.P$22, U$10.2, X2.GND
GND1: !AT.2, C22.1, C23.2, C24.2, C25.2, C26.2, C27.2, C28.2, C29.2, IC3.7, IC3.18, IC3.21, IC3.25, IC3.26, IC5.2, IC5.4, LED8.C, LED9.C, LTP.1, R36.1, R38.1, R40.1, U$15.P$1, UART.2, USB1.GND
GND2: !AT1.2, C34.1, C35.2, C36.2, C37.2, C38.2, C39.2, C40.2, C41.2, IC2.7, IC2.18, IC2.21, IC2.25, IC2.26, IC8.2, IC8.4, LED12.C, LED13.C, LTP1.1, R51.1, R53.1, R55.1, U$27.P$1, UART1.2, USB2.GND
GND3: C59.2, C60.2, C61.2, C62.2, C63.2, C64.2, C65.2, C66.2, C67.1, C68.2, C69.2, C70.2, C72.1, C73.2, C74.2, C75.2, C76.2, C77.2, C78.2, C79.2, C80.2, C81.2, C82.1, C83.1, GND2.PP, IC4.4, LED15.C, LED16.C, LIPO-2.TP, R77.1, R80.1, R92.2, R93.1, R95.1, R98.1, R104.1, U3.5, U3.18, U3.26, U3.36, U$35.1, U$35.11, U$35.18, U$36.3, U$36.13, U$36.C, U$37.2, U$38.2, U$39.2, U$40.P$13, U$40.P$14, U$40.P$21, U$40.P$22, X3.GND
GND4: C84.2, C85.2, C86.2, C87.2, C88.2, C89.2, C90.2, C91.2, C92.1, C93.2, C94.2, C95.2, C97.1, C98.2, C99.2, C100.2, C101.2, C102.2, C103.2, C104.2, C105.2, C106.2, C107.1, C108.1, GND3.PP, IC6.4, LED20.C, LED21.C, LIPO-3.TP, R107.1, R110.1, R122.2, R123.1, R125.1, R128.1, R134.1, U4.5, U4.18, U4.26, U4.36, U$46.1, U$46.11, U$46.18, U$47.3, U$47.13, U$47.C, U$48.2, U$49.2, U$50.2, U$51.P$13, U$51.P$14, U$51.P$21, U$51.P$22, X4.GND
GND5: C109.2, C110.2, C111.2, C112.2, C113.2, C114.2, C115.2, C116.2, C117.1, C118.2, C119.2, C120.2, C122.1, C123.2, C124.2, C125.2, C126.2, C127.2, C128.2, C129.2, C130.2, C131.2, C132.1, C133.1, GND4.PP, IC7.4, LED25.C, LED26.C, LIPO-4.TP, R137.1, R140.1, R152.2, R153.1, R155.1, R158.1, R164.1, U5.5, U5.18, U5.26, U5.36, U$57.1, U$57.11, U$57.18, U$58.3, U$58.13, U$58.C, U$59.2, U$60.2, U$61.2, U$62.P$13, U$62.P$14, U$62.P$21, U$62.P$22, X5.GND
GND6: !AT2.2, C42.1, C43.2, C44.2, C45.2, C46.2, C47.2, C48.2, C49.2, IC9.7, IC9.18, IC9.21, IC9.25, IC9.26, IC10.2, IC10.4, LED31.C, LED32.C, LTP2.1, R66.1, R68.1, R70.1, U$72.P$1, UART2.2, USB3.GND
GND7: C50.2, C51.2, C52.2, C53.2, C54.2, C55.2, C56.2, C57.2, C58.1, C134.2, C135.2, C136.2, C138.1, C139.2, C140.2, C141.2, C142.2, C143.2, C144.2, C145.2, C146.2, C147.2, C148.1, C149.1, GND1.PP, IC11.4, LED33.C, LED34.C, LIPO-1.TP, R167.1, R170.1, R182.2, R183.1, R185.1, R188.1, R194.1, U2.5, U2.18, U2.26, U2.36, U$81.1, U$81.11, U$81.18, U$82.3, U$82.13, U$82.C, U$83.2, U$84.2, U$85.2, U$86.P$13, U$86.P$14, U$86.P$21, U$86.P$22, X1.GND
GND8: C150.2, C151.2, C152.2, C153.2, C154.2, C155.2, C156.2, C157.2, C158.1, C159.2, C160.2, C161.2, C163.1, C164.2, C165.2, C166.2, C167.2, C168.2, C169.2, C170.2, C171.2, C172.2, C173.1, C174.1, GND5.PP, IC12.4, LED38.C, LED39.C, LIPO-5.TP, R197.1, R200.1, R212.2, R213.1, R215.1, R218.1, R224.1, U6.5, U6.18, U6.26, U6.36, U$92.1, U$92.11, U$92.18, U$93.3, U$93.13, U$93.C, U$94.2, U$95.2, U$96.2, U$97.P$13, U$97.P$14, U$97.P$21, U$97.P$22, X6.GND
GND9: !AT3.2, C175.1, C176.2, C177.2, C178.2, C179.2, C180.2, C181.2, C182.2, IC13.7, IC13.18, IC13.21, IC13.25, IC13.26, IC14.2, IC14.4, LED45.C, LED46.C, LTP3.1, R231.1, R233.1, R235.1, U$106.P$1, UART3.2, USB4.GND
GND10: C183.2, C184.2, C185.2, C186.2, C187.2, C188.2, C189.2, C190.2, C191.1, C192.2, C193.2, C194.2, C196.1, C197.2, C198.2, C199.2, C200.2, C201.2, C202.2, C203.2, C204.2, C205.2, C206.1, C207.1, GND6.PP, IC15.4, LED47.C, LED48.C, LIPO-6.TP, R242.1, R245.1, R257.2, R258.1, R260.1, R263.1, R269.1, U7.5, U7.18, U7.26, U7.36, U$115.1, U$115.11, U$115.18, U$116.3, U$116.13, U$116.C, U$117.2, U$118.2, U$119.2, U$120.P$13, U$120.P$14, U$120.P$21, U$120.P$22, X7.GND
GND11: !AT4.2, C208.1, C209.2, C210.2, C211.2, C212.2, C213.2, C214.2, C215.2, IC16.7, IC16.18, IC16.21, IC16.25, IC16.26, IC17.2, IC17.4, LED54.C, LED55.C, LTP4.1, R276.1, R278.1, R280.1, U$129.P$1, UART4.2, USB5.GND
GND12: C216.2, C217.2, C218.2, C219.2, C220.2, C221.2, C222.2, C223.2, C224.1, C225.2, C226.2, C227.2, C229.1, C230.2, C231.2, C232.2, C233.2, C234.2, C235.2, C236.2, C237.2, C238.2, C239.1, C240.1, GND7.PP, IC18.4, LED56.C, LED57.C, LIPO-7.TP, R287.1, R290.1, R302.2, R303.1, R305.1, R308.1, R314.1, U8.5, U8.18, U8.26, U8.36, U$138.1, U$138.11, U$138.18, U$139.3, U$139.13, U$139.C, U$140.2, U$141.2, U$142.2, U$143.P$13, U$143.P$14, U$143.P$21, U$143.P$22, X8.GND
LED1: R15.2, U1.30
LED2: R16.2, U1.29
LED3: R171.2, U2.30
LED4: R166.2, U2.29
LED5: R81.2, U3.30
LED6: R76.2, U3.29
LED7: R111.2, U4.30
LED8: R106.2, U4.29
LED9: R141.2, U5.30
LED10: R136.2, U5.29
LED11: R201.2, U6.30
LED12: R196.2, U6.29
LED13: R246.2, U7.30
LED14: R241.2, U7.29
LED15: R291.2, U8.30
LED16: R286.2, U8.29
LIPO: C4.1, C30.1, C32.2, IC1.8, L2.2, LIPO+.TP, ON/OFF.3, R12.2, U$2.3, U$6.2, U$7.2, U$8.2, U$9.2
LIPO1: C134.1, C146.1, C148.2, IC11.8, L4.2, LIPO+1.TP, ON/OFF1.3, R169.2, U$83.3, U$87.2, U$88.2, U$89.2, U$90.2
LIPO2: C68.1, C80.1, C82.2, IC4.8, L6.2, LIPO+2.TP, ON/OFF2.3, R79.2, U$37.3, U$41.2, U$42.2, U$43.2, U$44.2
LIPO3: C93.1, C105.1, C107.2, IC6.8, L8.2, LIPO+3.TP, ON/OFF3.3, R109.2, U$48.3, U$52.2, U$53.2, U$54.2, U$55.2
LIPO4: C118.1, C130.1, C132.2, IC7.8, L10.2, LIPO+4.TP, ON/OFF4.3, R139.2, U$59.3, U$63.2, U$64.2, U$65.2, U$66.2
LIPO5: C159.1, C171.1, C173.2, IC12.8, L12.2, LIPO+5.TP, ON/OFF5.3, R199.2, U$94.3, U$98.2, U$99.2, U$100.2, U$101.2
LIPO6: C192.1, C204.1, C206.2, IC15.8, L14.2, LIPO+6.TP, ON/OFF6.3, R244.2, U$117.3, U$121.2, U$122.2, U$123.2, U$124.2
LIPO7: C225.1, C237.1, C239.2, IC18.8, L16.2, LIPO+7.TP, ON/OFF7.3, R289.2, U$140.3, U$144.2, U$145.2, U$146.2, U$147.2
MISO: LTP.2, R41.2
MISO1: LTP1.2, R56.2
MISO2: LTP2.2, R71.2
MISO3: LTP3.2, R236.2
MISO4: LTP4.2, R281.2
MOSI: LTP.4, R37.2
MOSI1: LTP1.4, R52.2
MOSI2: LTP2.4, R67.2
MOSI3: LTP3.4, R232.2
MOSI4: LTP4.4, R277.2
MOT1: R18.1, U1.15
MOT2: R27.1, U1.16
MOT3: R25.1, U1.31
MOT4: R26.1, U1.32
MOT5: R192.1, U2.32
MOT6: R190.1, U2.15
MOT7: R193.1, U2.16
MOT8: R191.1, U2.31
MOT9: R102.1, U3.32
MOT10: R100.1, U3.15
MOT11: R103.1, U3.16
MOT12: R101.1, U3.31
MOT13: R132.1, U4.32
MOT14: R130.1, U4.15
MOT15: R133.1, U4.16
MOT16: R131.1, U4.31
MOT17: R162.1, U5.32
MOT18: R160.1, U5.15
MOT19: R163.1, U5.16
MOT20: R161.1, U5.31
MOT21: R222.1, U6.32
MOT22: R220.1, U6.15
MOT23: R223.1, U6.16
MOT24: R221.1, U6.31
MOT25: R267.1, U7.32
MOT26: R265.1, U7.15
MOT27: R268.1, U7.16
MOT28: R266.1, U7.31
MOT29: R312.1, U8.32
MOT30: R310.1, U8.15
MOT31: R313.1, U8.16
MOT32: R311.1, U8.31
MOT_GND: U$6.1, U$7.1, U$8.1, U$9.1, U$10.3
MOT_GND1: U$85.3, U$87.1, U$88.1, U$89.1, U$90.1
MOT_GND2: U$39.3, U$41.1, U$42.1, U$43.1, U$44.1
MOT_GND3: U$50.3, U$52.1, U$53.1, U$54.1, U$55.1
MOT_GND4: U$61.3, U$63.1, U$64.1, U$65.1, U$66.1
MOT_GND5: U$96.3, U$98.1, U$99.1, U$100.1, U$101.1
MOT_GND6: U$119.3, U$121.1, U$122.1, U$123.1, U$124.1
MOT_GND7: U$142.3, U$144.1, U$145.1, U$146.1, U$147.1
unnamed: LED2.C, R19.2
unnamed: U1.2, U$1.3
unnamed: R2.1, U$2.5
unnamed: R5.2, U$3.8
unnamed: C15.1, U$3.20
unnamed: C14.1, U$3.10
unnamed: R22.2, U$5.P$1
unnamed: LED3.A, R15.1
unnamed: LED4.A, R16.1
unnamed: BOOTMD.2, R17.2, R20.2
unnamed: R14.1, U$4.11
unnamed: R19.1, U$4.5
unnamed: R4.2, U$3.23
unnamed: LED1.C, R14.2
unnamed: R23.2, U$5.P$2
unnamed: R11.2, U$4.7
unnamed: R13.2, U$4.6
unnamed: R3.2, U$3.9
unnamed: R1.2, U$3.24
unnamed: R9.1, U$4.15
unnamed: R10.1, U$4.2
unnamed: R18.2, U$6.3
unnamed: D3.2, ON/OFF.1, R6.1, R7.2
unnamed: C8.2, IC1.6
unnamed: U1.3, U$1.1
unnamed: R30.1, U$5.P$34
unnamed: IC3.23, LED6.C
unnamed: C8.1, IC1.5
unnamed: IC3.22, LED7.C
unnamed: LED6.A, R31.1
unnamed: LED7.A, R32.1
unnamed: R33.1, U$21.P$1
unnamed: !AT.1, R33.2, R34.1
unnamed: R39.1, R40.2, U$17.P$1
unnamed: R37.1, R38.2, U$19.P$1
unnamed: R35.1, R36.2, U$20.P$1
unnamed: R41.1, U$16.P$1
unnamed: R27.2, U$7.3
unnamed: R25.2, U$8.3
unnamed: R26.2, U$9.3
unnamed: R42.1, U$12.P$1, UART.3
unnamed: R29.2, U$2.1
unnamed: LED5.C, R29.1
unnamed: C12.1, IC1.3, L2.1
unnamed: C13.1, IC1.2, L1.2
unnamed: R43.1, U$13.P$1, UART.1
unnamed: LED8.A, R44.1
unnamed: LED9.A, R45.1
unnamed: R44.2, U$23.P$1
unnamed: R45.2, U$22.P$1
unnamed: IC2.23, LED10.C
unnamed: IC2.22, LED11.C
unnamed: LED10.A, R46.1
unnamed: LED11.A, R47.1
unnamed: R48.1, U$33.P$1
unnamed: !AT1.1, R48.2, R49.1
unnamed: R54.1, R55.2, U$29.P$1
unnamed: R52.1, R53.2, U$31.P$1
unnamed: R50.1, R51.2, U$32.P$1
unnamed: R56.1, U$28.P$1
unnamed: R57.1, U$24.P$1, UART1.3
unnamed: R58.1, U$25.P$1, UART1.1
unnamed: LED12.A, R59.1
unnamed: LED13.A, R60.1
unnamed: R59.2, U$68.P$1
unnamed: R60.2, U$34.P$1
unnamed: IC9.23, LED14.C
unnamed: IC9.22, LED30.C
unnamed: LED14.A, R61.1
unnamed: LED30.A, R62.1
unnamed: R63.1, U$78.P$1
unnamed: !AT2.1, R63.2, R64.1
unnamed: R69.1, R70.2, U$74.P$1
unnamed: R67.1, R68.2, U$76.P$1
unnamed: R65.1, R66.2, U$77.P$1
unnamed: R71.1, U$73.P$1
unnamed: R72.1, U$69.P$1, UART2.3
unnamed: R73.1, U$70.P$1, UART2.1
unnamed: LED31.A, R74.1
unnamed: LED32.A, R75.1
unnamed: R74.2, U$80.P$1
unnamed: R75.2, U$79.P$1
unnamed: BOOTMD1.2, R167.2, R168.2
unnamed: BOOTMD2.2, R77.2, R78.2
unnamed: LED16.A, R76.1
unnamed: LED15.A, R81.1
unnamed: R82.1, U$36.11
unnamed: R83.1, U$36.5
unnamed: R84.2, U$36.7
unnamed: R85.2, U$36.6
unnamed: C65.1, U$35.20
unnamed: C66.1, U$35.10
unnamed: R89.2, U$35.8
unnamed: R88.2, U$35.23
unnamed: R87.2, U$35.9
unnamed: R86.2, U$35.24
unnamed: R90.1, U$36.15
unnamed: R91.1, U$36.2
unnamed: R92.1, U$37.5
unnamed: C71.1, IC4.5
unnamed: C71.2, IC4.6
unnamed: D2.2, ON/OFF2.1, R93.2, R94.1
unnamed: U3.2, U$38.3
unnamed: U3.3, U$38.1
unnamed: LED18.C, R83.2
unnamed: LED17.C, R82.2
unnamed: R96.2, U$40.P$1
unnamed: R97.2, U$40.P$2
unnamed: R99.2, U$37.1
unnamed: LED19.C, R99.1
unnamed: C70.1, IC4.3, L6.1
unnamed: C69.1, IC4.2, L5.2
unnamed: R100.2, U$41.3
unnamed: R103.2, U$42.3
unnamed: R101.2, U$43.3
unnamed: R102.2, U$44.3
unnamed: R105.1, U$40.P$34
unnamed: BOOTMD3.2, R107.2, R108.2
unnamed: LED21.A, R106.1
unnamed: LED20.A, R111.1
unnamed: R112.1, U$47.11
unnamed: R113.1, U$47.5
unnamed: R114.2, U$47.7
unnamed: R115.2, U$47.6
unnamed: C90.1, U$46.20
unnamed: C91.1, U$46.10
unnamed: R119.2, U$46.8
unnamed: R118.2, U$46.23
unnamed: R117.2, U$46.9
unnamed: R116.2, U$46.24
unnamed: R120.1, U$47.15
unnamed: R121.1, U$47.2
unnamed: R122.1, U$48.5
unnamed: C96.1, IC6.5
unnamed: C96.2, IC6.6
unnamed: D4.2, ON/OFF3.1, R123.2, R124.1
unnamed: U4.2, U$49.3
unnamed: U4.3, U$49.1
unnamed: LED23.C, R113.2
unnamed: LED22.C, R112.2
unnamed: R126.2, U$51.P$1
unnamed: R127.2, U$51.P$2
unnamed: R129.2, U$48.1
unnamed: LED24.C, R129.1
unnamed: C95.1, IC6.3, L8.1
unnamed: C94.1, IC6.2, L7.2
unnamed: R130.2, U$52.3
unnamed: R133.2, U$53.3
unnamed: R131.2, U$54.3
unnamed: R132.2, U$55.3
unnamed: R135.1, U$51.P$34
unnamed: BOOTMD4.2, R137.2, R138.2
unnamed: LED26.A, R136.1
unnamed: LED25.A, R141.1
unnamed: R142.1, U$58.11
unnamed: R143.1, U$58.5
unnamed: R144.2, U$58.7
unnamed: R145.2, U$58.6
unnamed: C115.1, U$57.20
unnamed: C116.1, U$57.10
unnamed: R149.2, U$57.8
unnamed: R148.2, U$57.23
unnamed: R147.2, U$57.9
unnamed: R146.2, U$57.24
unnamed: R150.1, U$58.15
unnamed: R151.1, U$58.2
unnamed: R152.1, U$59.5
unnamed: C121.1, IC7.5
unnamed: C121.2, IC7.6
unnamed: D5.2, ON/OFF4.1, R153.2, R154.1
unnamed: U5.2, U$60.3
unnamed: U5.3, U$60.1
unnamed: LED28.C, R143.2
unnamed: LED27.C, R142.2
unnamed: R156.2, U$62.P$1
unnamed: R157.2, U$62.P$2
unnamed: R159.2, U$59.1
unnamed: LED29.C, R159.1
unnamed: C120.1, IC7.3, L10.1
unnamed: C119.1, IC7.2, L9.2
unnamed: R160.2, U$63.3
unnamed: R163.2, U$64.3
unnamed: R161.2, U$65.3
unnamed: R162.2, U$66.3
unnamed: R165.1, U$62.P$34
unnamed: LED34.A, R166.1
unnamed: LED33.A, R171.1
unnamed: R172.1, U$82.11
unnamed: R173.1, U$82.5
unnamed: R174.2, U$82.7
unnamed: R175.2, U$82.6
unnamed: C56.1, U$81.20
unnamed: C57.1, U$81.10
unnamed: R179.2, U$81.8
unnamed: R178.2, U$81.23
unnamed: R177.2, U$81.9
unnamed: R176.2, U$81.24
unnamed: R180.1, U$82.15
unnamed: R181.1, U$82.2
unnamed: R182.1, U$83.5
unnamed: C137.1, IC11.5
unnamed: C137.2, IC11.6
unnamed: D1.2, ON/OFF1.1, R183.2, R184.1
unnamed: U2.2, U$84.3
unnamed: U2.3, U$84.1
unnamed: LED36.C, R173.2
unnamed: LED35.C, R172.2
unnamed: R186.2, U$86.P$1
unnamed: R187.2, U$86.P$2
unnamed: R189.2, U$83.1
unnamed: LED37.C, R189.1
unnamed: C136.1, IC11.3, L4.1
unnamed: C135.1, IC11.2, L3.2
unnamed: R190.2, U$87.3
unnamed: R193.2, U$88.3
unnamed: R191.2, U$89.3
unnamed: R192.2, U$90.3
unnamed: R195.1, U$86.P$34
unnamed: BOOTMD5.2, R197.2, R198.2
unnamed: LED39.A, R196.1
unnamed: LED38.A, R201.1
unnamed: R202.1, U$93.11
unnamed: R203.1, U$93.5
unnamed: R204.2, U$93.7
unnamed: R205.2, U$93.6
unnamed: C156.1, U$92.20
unnamed: C157.1, U$92.10
unnamed: R209.2, U$92.8
unnamed: R208.2, U$92.23
unnamed: R207.2, U$92.9
unnamed: R206.2, U$92.24
unnamed: R210.1, U$93.15
unnamed: R211.1, U$93.2
unnamed: R212.1, U$94.5
unnamed: C162.1, IC12.5
unnamed: C162.2, IC12.6
unnamed: D6.2, ON/OFF5.1, R213.2, R214.1
unnamed: U6.2, U$95.3
unnamed: U6.3, U$95.1
unnamed: LED41.C, R203.2
unnamed: LED40.C, R202.2
unnamed: R216.2, U$97.P$1
unnamed: R217.2, U$97.P$2
unnamed: R219.2, U$94.1
unnamed: LED42.C, R219.1
unnamed: C161.1, IC12.3, L12.1
unnamed: C160.1, IC12.2, L11.2
unnamed: R220.2, U$98.3
unnamed: R223.2, U$99.3
unnamed: R221.2, U$100.3
unnamed: R222.2, U$101.3
unnamed: R225.1, U$97.P$34
unnamed: IC13.23, LED43.C
unnamed: IC13.22, LED44.C
unnamed: LED43.A, R226.1
unnamed: LED44.A, R227.1
unnamed: R228.1, U$112.P$1
unnamed: !AT3.1, R228.2, R229.1
unnamed: R234.1, R235.2, U$108.P$1
unnamed: R232.1, R233.2, U$110.P$1
unnamed: R230.1, R231.2, U$111.P$1
unnamed: R236.1, U$107.P$1
unnamed: R237.1, U$103.P$1, UART3.3
unnamed: R238.1, U$104.P$1, UART3.1
unnamed: LED45.A, R239.1
unnamed: LED46.A, R240.1
unnamed: R239.2, U$114.P$1
unnamed: R240.2, U$113.P$1
unnamed: BOOTMD6.2, R242.2, R243.2
unnamed: LED48.A, R241.1
unnamed: LED47.A, R246.1
unnamed: R247.1, U$116.11
unnamed: R248.1, U$116.5
unnamed: R249.2, U$116.7
unnamed: R250.2, U$116.6
unnamed: C189.1, U$115.20
unnamed: C190.1, U$115.10
unnamed: R254.2, U$115.8
unnamed: R253.2, U$115.23
unnamed: R252.2, U$115.9
unnamed: R251.2, U$115.24
unnamed: R255.1, U$116.15
unnamed: R256.1, U$116.2
unnamed: R257.1, U$117.5
unnamed: C195.1, IC15.5
unnamed: C195.2, IC15.6
unnamed: D7.2, ON/OFF6.1, R258.2, R259.1
unnamed: U7.2, U$118.3
unnamed: U7.3, U$118.1
unnamed: LED50.C, R248.2
unnamed: LED49.C, R247.2
unnamed: R261.2, U$120.P$1
unnamed: R262.2, U$120.P$2
unnamed: R264.2, U$117.1
unnamed: LED51.C, R264.1
unnamed: C194.1, IC15.3, L14.1
unnamed: C193.1, IC15.2, L13.2
unnamed: R265.2, U$121.3
unnamed: R268.2, U$122.3
unnamed: R266.2, U$123.3
unnamed: R267.2, U$124.3
unnamed: R270.1, U$120.P$34
unnamed: IC16.23, LED52.C
unnamed: IC16.22, LED53.C
unnamed: LED52.A, R271.1
unnamed: LED53.A, R272.1
unnamed: R273.1, U$135.P$1
unnamed: !AT4.1, R273.2, R274.1
unnamed: R279.1, R280.2, U$131.P$1
unnamed: R277.1, R278.2, U$133.P$1
unnamed: R275.1, R276.2, U$134.P$1
unnamed: R281.1, U$130.P$1
unnamed: R282.1, U$126.P$1, UART4.3
unnamed: R283.1, U$127.P$1, UART4.1
unnamed: LED54.A, R284.1
unnamed: LED55.A, R285.1
unnamed: R284.2, U$137.P$1
unnamed: R285.2, U$136.P$1
unnamed: BOOTMD7.2, R287.2, R288.2
unnamed: LED57.A, R286.1
unnamed: LED56.A, R291.1
unnamed: R292.1, U$139.11
unnamed: R293.1, U$139.5
unnamed: R294.2, U$139.7
unnamed: R295.2, U$139.6
unnamed: C222.1, U$138.20
unnamed: C223.1, U$138.10
unnamed: R299.2, U$138.8
unnamed: R298.2, U$138.23
unnamed: R297.2, U$138.9
unnamed: R296.2, U$138.24
unnamed: R300.1, U$139.15
unnamed: R301.1, U$139.2
unnamed: R302.1, U$140.5
unnamed: C228.1, IC18.5
unnamed: C228.2, IC18.6
unnamed: D8.2, ON/OFF7.1, R303.2, R304.1
unnamed: U8.2, U$141.3
unnamed: U8.3, U$141.1
unnamed: LED59.C, R293.2
unnamed: LED58.C, R292.2
unnamed: R306.2, U$143.P$1
unnamed: R307.2, U$143.P$2
unnamed: R309.2, U$140.1
unnamed: LED60.C, R309.1
unnamed: C227.1, IC18.3, L16.1
unnamed: C226.1, IC18.2, L15.2
unnamed: R310.2, U$144.3
unnamed: R313.2, U$145.3
unnamed: R311.2, U$146.3
unnamed: R312.2, U$147.3
unnamed: R315.1, U$143.P$34
PWR_OFF: R6.2, R30.2, U1.8
PWR_OFF1: R184.2, R195.2, U2.8
PWR_OFF2: R94.2, R105.2, U3.8
PWR_OFF3: R124.2, R135.2, U4.8
PWR_OFF4: R154.2, R165.2, U5.8
PWR_OFF5: R214.2, R225.2, U6.8
PWR_OFF6: R259.2, R270.2, U7.8
PWR_OFF7: R304.2, R315.2, U8.8
PWR_ON: D3.3, IC1.7, R8.2
PWR_ON1: D1.3, IC11.7, R185.2
PWR_ON2: D2.3, IC4.7, R95.2
PWR_ON3: D4.3, IC6.7, R125.2
PWR_ON4: D5.3, IC7.7, R155.2
PWR_ON5: D6.3, IC12.7, R215.2
PWR_ON6: D7.3, IC15.7, R260.2
PWR_ON7: D8.3, IC18.7, R305.2
PWR_ON_µC: D3.1, R28.2, U1.17
PWR_ON_µC1: D1.1, R194.2, U2.17
PWR_ON_µC2: D2.1, R104.2, U3.17
PWR_ON_µC3: D4.1, R134.2, U4.17
PWR_ON_µC4: D5.1, R164.2, U5.17
PWR_ON_µC5: D6.1, R224.2, U6.17
PWR_ON_µC6: D7.1, R269.2, U7.17
PWR_ON_µC7: D8.1, R314.2, U8.17
RESET1: C9.2, U1.4
RESET2: C138.2, U2.4
RESET3: C72.2, U3.4
RESET4: C97.2, U4.4
RESET5: C122.2, U5.4
RESET6: C163.2, U6.4
RESET7: C196.2, U7.4
RESET8: C229.2, U8.4
SPI1_CS: R5.1, U1.11
SPI1_CS1: R179.1, U2.11
SPI1_CS2: R89.1, U3.11
SPI1_CS3: R119.1, U4.11
SPI1_CS4: R149.1, U5.11
SPI1_CS5: R209.1, U6.11
SPI1_CS6: R254.1, U7.11
SPI1_CS7: R299.1, U8.11
SPI1_MISO: R3.1, U1.13
SPI1_MISO1: R177.1, U2.13
SPI1_MISO2: R87.1, U3.13
SPI1_MISO3: R117.1, U4.13
SPI1_MISO4: R147.1, U5.13
SPI1_MISO5: R207.1, U6.13
SPI1_MISO6: R252.1, U7.13
SPI1_MISO7: R297.1, U8.13
SPI1_MOSI: R1.1, U1.14
SPI1_MOSI1: R176.1, U2.14
SPI1_MOSI2: R86.1, U3.14
SPI1_MOSI3: R116.1, U4.14
SPI1_MOSI4: R146.1, U5.14
SPI1_MOSI5: R206.1, U6.14
SPI1_MOSI6: R251.1, U7.14
SPI1_MOSI7: R296.1, U8.14
SPI1_SCK: R4.1, U1.12
SPI1_SCK1: R178.1, U2.12
SPI1_SCK2: R88.1, U3.12
SPI1_SCK3: R118.1, U4.12
SPI1_SCK4: R148.1, U5.12
SPI1_SCK5: R208.1, U6.12
SPI1_SCK6: R253.1, U7.12
SPI1_SCK7: R298.1, U8.12
SWCLK: SWCLK.PP, U1.28
SWCLK1: SWCLK1.PP, U2.28
SWCLK2: SWCLK2.PP, U3.28
SWCLK3: SWCLK3.PP, U4.28
SWCLK4: SWCLK4.PP, U5.28
SWCLK5: SWCLK5.PP, U6.28
SWCLK6: SWCLK6.PP, U7.28
SWCLK7: SWCLK7.PP, U8.28
SWDIO: SWDIO.PP, U1.25
SWDIO1: SWDIO1.PP, U2.25
SWDIO2: SWDIO2.PP, U3.25
SWDIO3: SWDIO3.PP, U4.25
SWDIO4: SWDIO4.PP, U5.25
SWDIO5: SWDIO5.PP, U6.25
SWDIO6: SWDIO6.PP, U7.25
SWDIO7: SWDIO7.PP, U8.25
USART1_RX: R9.2, U1.22
USART1_RX1: R180.2, U2.22
USART1_RX2: R90.2, U3.22
USART1_RX3: R120.2, U4.22
USART1_RX4: R150.2, U5.22
USART1_RX5: R210.2, U6.22
USART1_RX6: R255.2, U7.22
USART1_RX7: R300.2, U8.22
USART1_TX: R10.2, U1.21
USART1_TX1: R181.2, U2.21
USART1_TX2: R91.2, U3.21
USART1_TX3: R121.2, U4.21
USART1_TX4: R151.2, U5.21
USART1_TX5: R211.2, U6.21
USART1_TX6: R256.2, U7.21
USART1_TX7: R301.2, U8.21
USART2_RX: R22.1, U1.10
USART2_RX1: R186.1, U2.10
USART2_RX2: R96.1, U3.10
USART2_RX3: R126.1, U4.10
USART2_RX4: R156.1, U5.10
USART2_RX5: R216.1, U6.10
USART2_RX6: R261.1, U7.10
USART2_RX7: R306.1, U8.10
USART2_TX: R23.1, U1.9
USART2_TX1: R187.1, U2.9
USART2_TX2: R97.1, U3.9
USART2_TX3: R127.1, U4.9
USART2_TX4: R157.1, U5.9
USART2_TX5: R217.1, U6.9
USART2_TX6: R262.1, U7.9
USART2_TX7: R307.1, U8.9
USART_RX: IC3.1, R43.2
USART_RX1: IC2.1, R58.2
USART_RX2: IC9.1, R73.2
USART_RX3: IC13.1, R238.2
USART_RX4: IC16.1, R283.2
USART_TX: IC3.5, R42.2
USART_TX1: IC2.5, R57.2
USART_TX2: IC9.5, R72.2
USART_TX3: IC13.5, R237.2
USART_TX4: IC16.5, R282.2
VBUS: C6.2, C16.1, LED5.A, U$2.4, U$4.10, X2.VBUS
VBUS1: C54.1, C58.2, LED37.A, U$82.10, U$83.4, X1.VBUS
VBUS2: C63.1, C67.2, LED19.A, U$36.10, U$37.4, X3.VBUS
VBUS3: C88.1, C92.2, LED24.A, U$47.10, U$48.4, X4.VBUS
VBUS4: C113.1, C117.2, LED29.A, U$58.10, U$59.4, X5.VBUS
VBUS5: C154.1, C158.2, LED42.A, U$93.10, U$94.4, X6.VBUS
VBUS6: C187.1, C191.2, LED51.A, U$116.10, U$117.4, X7.VBUS
VBUS7: C220.1, C224.2, LED60.A, U$139.10, U$140.4, X8.VBUS
VCC: BOOTMD.1, C1.1, C2.1, C3.1, C5.1, C7.1, C10.1, C11.1, C21.1, C31.1, C33.2, L1.1, R24.2, U1.1, U1.6, U1.19, U1.27, U$3.13, U$5.P$11, U$5.P$12, U$10.1
VCC1: BOOTMD1.1, C55.1, C139.1, C140.1, C141.1, C142.1, C143.1, C144.1, C145.1, C147.1, C149.2, L3.1, R188.2, U2.1, U2.6, U2.19, U2.27, U$81.13, U$85.1, U$86.P$11, U$86.P$12
VCC2: BOOTMD2.1, C64.1, C73.1, C74.1, C75.1, C76.1, C77.1, C78.1, C79.1, C81.1, C83.2, L5.1, R98.2, U3.1, U3.6, U3.19, U3.27, U$35.13, U$39.1, U$40.P$11, U$40.P$12
VCC3: BOOTMD3.1, C89.1, C98.1, C99.1, C100.1, C101.1, C102.1, C103.1, C104.1, C106.1, C108.2, L7.1, R128.2, U4.1, U4.6, U4.19, U4.27, U$46.13, U$50.1, U$51.P$11, U$51.P$12
VCC4: BOOTMD4.1, C114.1, C123.1, C124.1, C125.1, C126.1, C127.1, C128.1, C129.1, C131.1, C133.2, L9.1, R158.2, U5.1, U5.6, U5.19, U5.27, U$57.13, U$61.1, U$62.P$11, U$62.P$12
VCC5: BOOTMD5.1, C155.1, C164.1, C165.1, C166.1, C167.1, C168.1, C169.1, C170.1, C172.1, C174.2, L11.1, R218.2, U6.1, U6.6, U6.19, U6.27, U$92.13, U$96.1, U$97.P$11, U$97.P$12
VCC6: BOOTMD6.1, C188.1, C197.1, C198.1, C199.1, C200.1, C201.1, C202.1, C203.1, C205.1, C207.2, L13.1, R263.2, U7.1, U7.6, U7.19, U7.27, U$115.13, U$119.1, U$120.P$11, U$120.P$12
VCC7: BOOTMD7.1, C221.1, C230.1, C231.1, C232.1, C233.1, C234.1, C235.1, C236.1, C238.1, C240.2, L15.1, R308.2, U8.1, U8.6, U8.19, U8.27, U$138.13, U$142.1, U$143.P$11, U$143.P$12
VCCIO: C19.1, LED1.A, LED2.A, U$4.1, U$4.8, U$4.9
VCCIO1: C53.1, LED35.A, LED36.A, U$82.1, U$82.8, U$82.9
VCCIO2: C62.1, LED17.A, LED18.A, U$36.1, U$36.8, U$36.9
VCCIO3: C87.1, LED22.A, LED23.A, U$47.1, U$47.8, U$47.9
VCCIO4: C112.1, LED27.A, LED28.A, U$58.1, U$58.8, U$58.9
VCCIO5: C153.1, LED40.A, LED41.A, U$93.1, U$93.8, U$93.9
VCCIO6: C186.1, LED49.A, LED50.A, U$116.1, U$116.8, U$116.9
VCCIO7: C219.1, LED58.A, LED59.A, U$139.1, U$139.8, U$139.9
VDD5.0: C22.2, C27.1, IC3.20, IC5.1, R31.2, R32.2, USB1.VBUS
VDD5.1: C34.2, C40.1, IC2.20, IC8.1, R46.2, R47.2, USB2.VBUS
VDD5.2: C42.2, C48.1, IC9.20, IC10.1, R61.2, R62.2, USB3.VBUS
VDD5.3: C175.2, C181.1, IC13.20, IC14.1, R226.2, R227.2, USB4.VBUS
VDD5.4: C208.2, C214.1, IC16.20, IC17.1, R271.2, R272.2, USB5.VBUS
VDDIO: C25.1, IC3.4, IC3.17, IC3.19
VDDIO1: C37.1, IC2.4, IC2.17, IC2.19
VDDIO2: C45.1, IC9.4, IC9.17, IC9.19
VDDIO3: C178.1, IC13.4, IC13.17, IC13.19
VDDIO4: C211.1, IC16.4, IC16.17, IC16.19
VOLTAGE: C20.1, R12.1, R21.2, U1.7
VOLTAGE1: C50.1, R169.1, R170.2, U2.7
VOLTAGE2: C59.1, R79.1, R80.2, U3.7
VOLTAGE3: C84.1, R109.1, R110.2, U4.7
VOLTAGE4: C109.1, R139.1, R140.2, U5.7
VOLTAGE5: C150.1, R199.1, R200.2, U6.7
VOLTAGE6: C183.1, R244.1, R245.2, U7.7
VOLTAGE7: C216.1, R289.1, R290.2, U8.7
