kounst/daGloane/SW/include/main.h

/*
 * main.h
 *
 *  Created on: Oct 20, 2012
 *      Author: konstantin
 */

#ifndef MAIN_H_
#define MAIN_H_

//We have to consider the endianness of the plattform here.
//union _mpudata
//{
//	uint8_t bytes[14];
//	struct { int16_t gyro_z, gyro_y, gyro_x, temp, acc_z, acc_y, acc_x; } words;
//	//int16_t gyro_z, gyro_y, gyro_x, temp, acc_z, acc_y, acc_x;
//};

#define sin_45deg 0.70710678118



/* Function prototypes */
void RCC_Configuration(void);
void NVIC_Configuration(void);
void GetCalibrationData(void);


#endif /* MAIN_H_ */
