kounst/daGloane/remote/src/TIM.c

/*
 * TIM.c
 *
 *  Created on: Nov 3, 2012
 *      Author: konstantin
 */


/* Includes ------------------------------------------------------------------*/
#include "stm32f10x.h"
#include "TIM.h"


static __IO uint32_t TimingDelay;


void TIM4_Configuration(void)
{
  TIM_ICInitTypeDef  TIM_ICInitStructure;
  TIM_ICInitStructure.TIM_Channel = TIM_Channel_4;
  TIM_ICInitStructure.TIM_ICPolarity = TIM_ICPolarity_Falling;
  TIM_ICInitStructure.TIM_ICSelection = TIM_ICSelection_DirectTI;
  TIM_ICInitStructure.TIM_ICPrescaler = TIM_ICPSC_DIV1;
  TIM_ICInitStructure.TIM_ICFilter = 0x0;
  TIM_ICInit(TIM4, &TIM_ICInitStructure);
  TIM_SelectInputTrigger(TIM4, TIM_TS_TI2FP2);

  TIM_InternalClockConfig(TIM4);
  TIM_TimeBaseInitTypeDef TIM_TimeBaseStructure;
  TIM_TimeBaseStructure.TIM_Period = 0xFFFF;
  TIM_TimeBaseStructure.TIM_Prescaler = 5;   // fCK_PSC / (5 + 1)    1ms = 4000
  TIM_TimeBaseStructure.TIM_ClockDivision = TIM_CKD_DIV1;
  TIM_TimeBaseStructure.TIM_CounterMode = TIM_CounterMode_Up;
  TIM_TimeBaseInit(TIM4, & TIM_TimeBaseStructure);

  /* TIM enable counter */
  TIM_Cmd(TIM4, ENABLE);

  /* Enable the CC4 Interrupt Request */
  TIM_ITConfig(TIM4, TIM_IT_CC4, ENABLE);
}

/**
 * @brief  Configures the SysTick.
 * @param  None
 * @retval None
 */
void SysTick_Configuration(void)
{

	/* Setup SysTick Timer for 1 msec interrupts  */
	if (SysTick_Config(SystemCoreClock / 1000))
	{
		/* Capture error */
		while (1);
	}


}


/**
 * @brief  Inserts a delay time.
 * @param  nTime: specifies the delay time length, in milliseconds.
 * @retval None
 */
void Delay(__IO uint32_t nTime)
{
	TimingDelay = nTime;

	while(TimingDelay > 0);
}

/**
 * @brief  Decrements the TimingDelay variable.
 * @param  None
 * @retval None
 */
void TimingDelay_Decrement(void)
{
	if (TimingDelay != 0x00)
	{
		TimingDelay -= 1;
	}
}
