kounst/daGloane/SW/include/cobs.h

/* Copyright 2011, Jacques Fortier. All rights reserved.
 *
 * Redistribution and use in source and binary forms are permitted, with or without modification.
 */
#ifndef COBS_H
#define COBS_H

#include <stdint.h>
#include <stddef.h>

size_t cobs_encode(const uint8_t * input, size_t length, uint8_t * output);
size_t cobs_decode(const uint8_t * input, size_t length, uint8_t * output);
uint8_t cobs_encode_(uint8_t * inout, size_t length);

#endif
