kounst/daGloane/(commit log)

2012-07-07 DC/DC layout done
    [daGloane.brd, daGloane.sch]
2012-07-08 layout of center piece is done!
    [daGloane.brd]
2012-07-08 package added to HK03 BLDC controller library
2012-07-08 testpads replaced with HK03 bldc controller symbol & package
    [daGloane.brd, daGloane.sch]
2012-07-08 routing completed!! optimization pending
    [daGloane.brd, daGloane.sch]
2012-07-08 orientation of BLDC controllers changed
    [daGloane.brd]
2012-07-08 GND shape outline changed
    [daGloane.brd]
2012-07-08 estimation of the total weight of daGloane
    [Gewicht_abschätzung.ods]
2012-07-10 RefDesignators position rearranged
    [daGloane.brd]
2012-07-11 DC/DC layout improved
    [daGloane.brd]
2012-07-11 RefDesignator rearranged
    [daGloane.brd]
2012-07-11 DRC error resolved
    [daGloane.brd]
2012-07-11 error in schematic fixed: Wrong pin of MPU6000 connected to GND
    [daGloane.brd, daGloane.sch]
2012-07-13 Update BLDC
2012-07-15 - micro usb connector with electrical connection to mounting pad added - micro usb connector replaced with new part - micro usb connectors mounting pads' size increased with shape. This is to increas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
    [daGloane.brd, daGloane.sch]
2012-07-15 hole diameter for mounting of the motors changed. 2.95mm to 2.90mm
    [daGloane.brd]
2012-07-15 usb connectors added
    [BOM_abschätung.ods]
2012-07-21 logo placed on pcb
    [daGloane.brd]
2012-07-21 trace angles fixed
    [daGloane.brd]
2012-07-29 changed connection of the bluetooth module's AT pin.
    It is now connected to the pwr_on/off logic. This will set it into AT mode at startup so the µC can configure the module. Once the configuration is done the µC can set it into operating mode by simply sending a AT+RESET command.
    [daGloane.brd, daGloane.sch]
2012-07-30 initial commit of BT interface PCB
    [BT_interface.brd, BT_interface.sch]
2012-07-30 labels changed, parts smashed, labels resized and rearranged
    [BT_interface.brd, BT_interface.sch]
2012-07-30 layout finished
    [BT_interface.brd, BT_interface.sch]
2012-07-30 footprint for spring loaded header added
2012-07-31 added status LED
    [BT_interface.brd]
2012-07-31 parts rearranged to leave more space for BT module
    [BT_interface.brd, BT_interface.sch]
2012-07-31 Reference Designators resized rearranged
    [BT_interface.brd]
2012-08-12 bluetooths footprint corrected to actual dimensions
2012-08-12 bluetooth module replaced with new version
    [daGloane.brd, daGloane.sch]
2012-08-12 bluetooth module footprint corrected to match actual dimensions
2012-08-12 bluetooth module footprint removed and replaced with dummy drawing
    [BT_interface.brd, BT_interface.sch]
2012-08-12 stm32 vqfpn36 package cream layer divided in 4 segments
    [daGloane.brd, daGloane.sch]
2012-08-12 gnd shape slightly changed
    [BT_interface.brd]
2012-08-12 initial commit daGlaone panelized
    [daGloane_panel.brd]
2012-08-13 changed some values
    [daGloane.brd, daGloane.sch]
2012-08-13 resistor values for LEDs changed back; voltage drop over LEDs at 10mA is 2V. Therefore the voltage drop accross the resistor has to be 1.3V (3.3V supply) --> R = 1.3V / 10mA = 130Ohm; next E12 value 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
    [daGloane.brd, daGloane.sch]
2012-08-15 initial commit of gerber files
2012-08-17 silkscreen of STM32 and FT230 modified
2012-08-17 silkscreen of stm32 and FT230 modified outline of maximum usable boadspace in eagle freeware version removed
    [daGloane.brd, daGloane.sch]
2012-08-20 gerber data for daGlaone and BTinterface
2012-08-20 font type changed to vector
    [daGloane.brd]
2012-09-16 motor mounting holes diamenters changed to 3.4mm
    [daGloane.brd]
2012-09-22 PWM testcode implemented
2012-10-13 -spi reading from the MPU-6000 is now working (polling mode) -single byte read -continous reading of several bytes - UART command line interface implemented -this was done my using a library by Thoma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
2012-10-13 missing files for SPI and serial command interface (uAC) added string compare function in uAC changed to be case insensitive
    [SPI.c, SPI.h, uAC.c, uAC.h]
2012-10-14 compile switch added to make uac's string compare case insensitive
2012-10-15 Bit manipulation of data read ofer SPI replaced with union This made it necessary to change the order of high and low byte read from the SPI.
    [SPI.c, main.c]
2012-10-20 SysTick timer related functions move from main.c to this files
2012-10-20 some functions and prototypes move to other source and header files
2012-10-20 typedef and function prototypes move from main.c to this file
2012-10-20 initial commit of an implementation of the kalman filter. This is completely untested
2012-10-20 printf did't work properly for float smaller than 0 and bigger than -1 This bug fix is untested
    [uAC.c]
2012-10-20 uAC command attach function created
2012-10-20 power button handling moved to seperate funciton in GPIO.c
2012-10-20 missing include of TIM.h added
    [SPI.c]
2012-10-25 Remapping of JTAG pins activated. Initialization of LED and PWM3 IOs fixed
    [GPIO.c]
2012-10-25 Heatbeat function added
2012-10-25 this source file implements Consistent Overhead Byte Stuffing. This will be used for the UART communication over the BT module
2012-11-02 prototypes for SPI1_read() and SPI_writebyte() functions added
2012-11-05 disciption of the uart message protocoll to be used by daGloane for communication over BT interface
2012-11-07 PWM update function implemented uac function to set PWM duty-cycle implemented
2012-11-08 heart beat led now fades on and off with a 0.5Hz frequency
2012-11-08 LED fading can be controled with a uac command
2012-11-08 mapping of data in union replaced with function that does bitshifting. This just makes to code way easier to read.
    [SPI.c, SPI.h, main.c, main.h]
2012-11-11 kalman filter activated for testing
2012-11-11 incorrect mapping of data in MPU_read function fixed
    [SPI.c]
2012-11-11 function for kalman filter tuning implemented
2012-11-23 scaling of temperatur data provided by mpu-6000 done
2012-11-23 new uac commands: - changing of baudrate uart connected to BT module - sending of data to the BT module
2012-11-23 UART2 enabled for communication with the BT module
2012-11-23 configuration of UART2 for BT communication
2012-11-25 private function prototypes moved from header to source file calls of alloca function removed
2012-11-25 both LEDs are now turned on in case of an hard fault
2012-12-02 New version of daGloane HW. - There is almost no current consumption when turned off. Its not necessary to disconnect battery anymore.
    [daGloane1.1.brd, daGloane1.1.sch]
2013-03-10 PWM frequency changed 333Hz 3ms
2013-03-10 help string changed to reflect changes made to PWM
2013-03-10 rotation of gyro signals to prop coordinate system (rotation in z axis by 45 degree) implemented
2013-03-16 order of channels in BT_message mapping to local variable corrected
    [com.c]
2013-03-16 uac command for reading back the pwm values implemented
2013-03-16 gyro data are no longer transmitted via bluetooth interface on uart 2
    [main.c]
2013-03-16 initial commit of the daGloane Remote
    The target is to make the daGloane qaudcopter controlable using a Android Smartphone.
    For now to ease devolempent a common RC remote control will be used.
    daGloane Remote is a stm32 discovery eval board and a bluetooth interface that can be connected to a RC remote control. It will read the PPM signal of the remote and transfer the channel information via bluetooth to daGloane.
2013-09-09 Controller and Filter in Simulink. Looking for building a C model via Matlab
2013-09-10 Erste Version des auf C konvertierten Simulink Codes
    [complementary_controller.obj, complementary_controller_data.obj, rtGetInf.obj, rtGetNaN.obj, rt_logging.obj, rt_nonfinite.obj]
2013-10-06 data collected testing the complementary filter
    [complementary_filter.ods]
2013-10-08 Systick clock frequency changed to 250Hz
2013-10-08 uac command "getpwm" now returns the Motor pwm instead of the remote control pwm signals
2013-10-08 functions for uart dma data transfer added
2013-10-08 tigger flag for main loop execution added; this flag is set in the systick interrupt and is reset in the main loop
2013-10-08 main loop is only being executed if the tigger flag is set; the trigger flag is set by the systick interrupt which is fired at a rate of 250Hz
2013-11-14 pid values can now be changed via bluetooth
2021-02-15 step file of pcb added
    [DAGLOANE.SLDPRT, DAGLOANE.STEP]
2021-02-17 Programming fixture added
    [PCB_serialWire.FCStd]
2021-02-18 Programming fixture improved
    [PCB_serialWire.FCStd, SerialWire Fixture.stl]
2021-03-01 migration to platfromio and STM32Cube libraries made
